caee/Low-Cost-Bioprinter/Figures/Printer_side.png

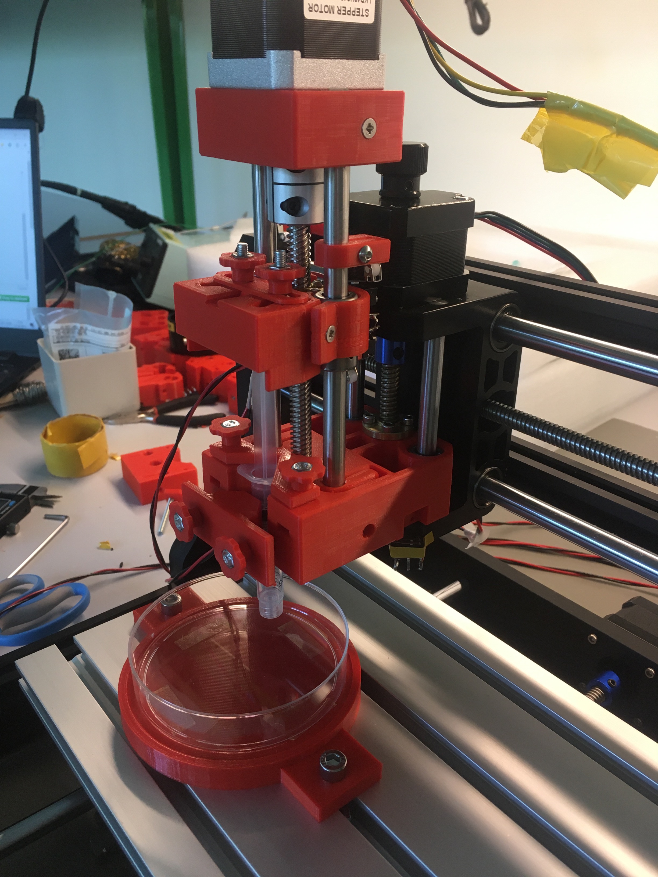
Figures/Printer_side.png
