caee/Low-Cost-Bioprinter/Design/Syringe/Open-Source_Syringe_Pump_4194094/images/featured_preview_glass_100ul.jpg

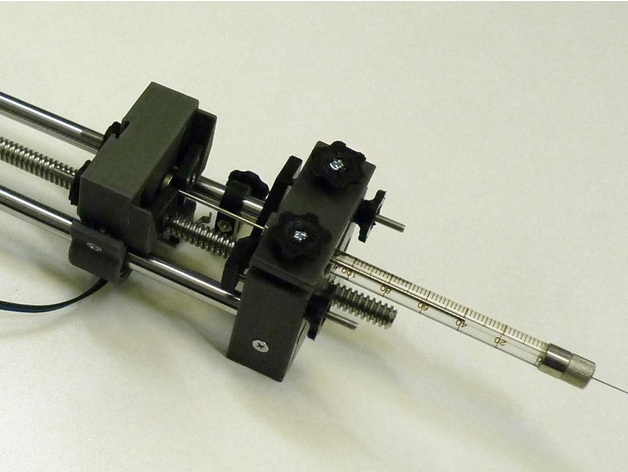
Design/Syringe/Open-Source_Syringe_Pump_4194094/images/featured_preview_glass_100ul.jpg
