caee/Low-Cost-Bioprinter/Design/Syringe/Ender3-syringe-pumps-main/README.md

# Ender 3 syringe pumps: 
open-source set of syringe pumps from an Ender 3 kit

**If you use the pump in your research, please cite:**

**Sander Baas, Vittorio Saggiomo,
Ender3 3D printer kit transformed into open, programmable syringe pump set,
HardwareX, Volume 10, 2021,
e00219, https://doi.org/10.1016/j.ohx.2021.e00219.**



Visit [**ChemRxiv**][2] for the preprint, and [**HardwareX**][3] for the published paper. 

A video of the project is here: https://www.youtube.com/watch?v=etUp4s1Bq-I

Ender 3 syringe pumps is an open source and open hardware device for converting an Ender 3 kit to a set of 3 syringe pumps. Almost everything needed for the build is the Ender 3 kit, even all the screws and the tools needed for the assembly. 
The only parts which needed to be bought are three 5x5 shaft couplers and M5 lead screw. 
All the 3D designs are in the /hardware folder. 

## Structure 
+ /hardware is a folder with the 3D printable files and a guide for the assembly 
+ /software is a folder with the instruction on how to use the pumps via gcode 
+ /videos are few video of the pumps in action

[1]: https://github.com/Vsaggiomo/Ender3-syringe-pumps/blob/main/Figures/fig1.jpg
[2]: https://chemrxiv.org/articles/preprint/Ender3_3D_Printer_Kit_Transformed_into_Open_Programmable_Syringe_Pump_Set/14718183 
[3]: https://doi.org/10.1016/j.ohx.2021.e00219
