caee/Low-Cost-Bioprinter/Design/Syringe/Open-Source_Syringe_Pump_4194094/README.txt

Open-Source Syringe Pump by AndreySamokhin on Thingiverse: https://www.thingiverse.com/thing:4194094
