caee/Low-Cost-Bioprinter/Design/Syringe/Open-Source_Syringe_Pump_4194094/images/featured_preview_generalView_800x600.JPG

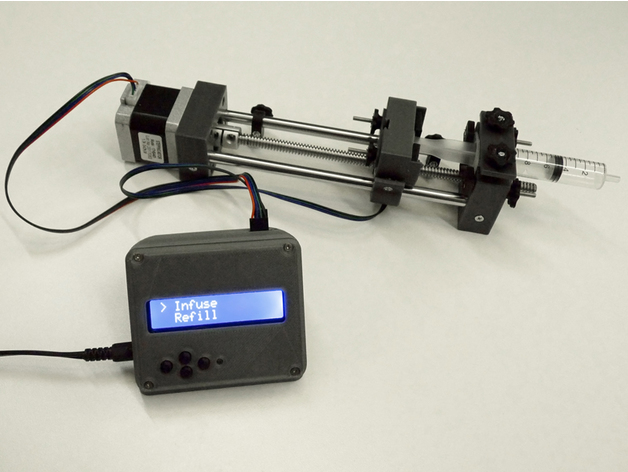
Design/Syringe/Open-Source_Syringe_Pump_4194094/images/featured_preview_generalView_800x600.JPG
