caee/Low-Cost-Bioprinter/Design/Syringe/Open-Source_Syringe_Pump_4194094/images/featured_preview_plastic_20mL.jpg

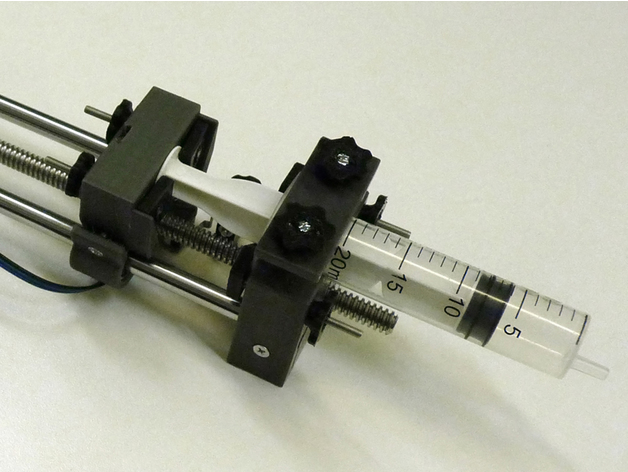
Design/Syringe/Open-Source_Syringe_Pump_4194094/images/featured_preview_plastic_20mL.jpg
