caee/Low-Cost-Bioprinter/Figures/backsupport.JPG

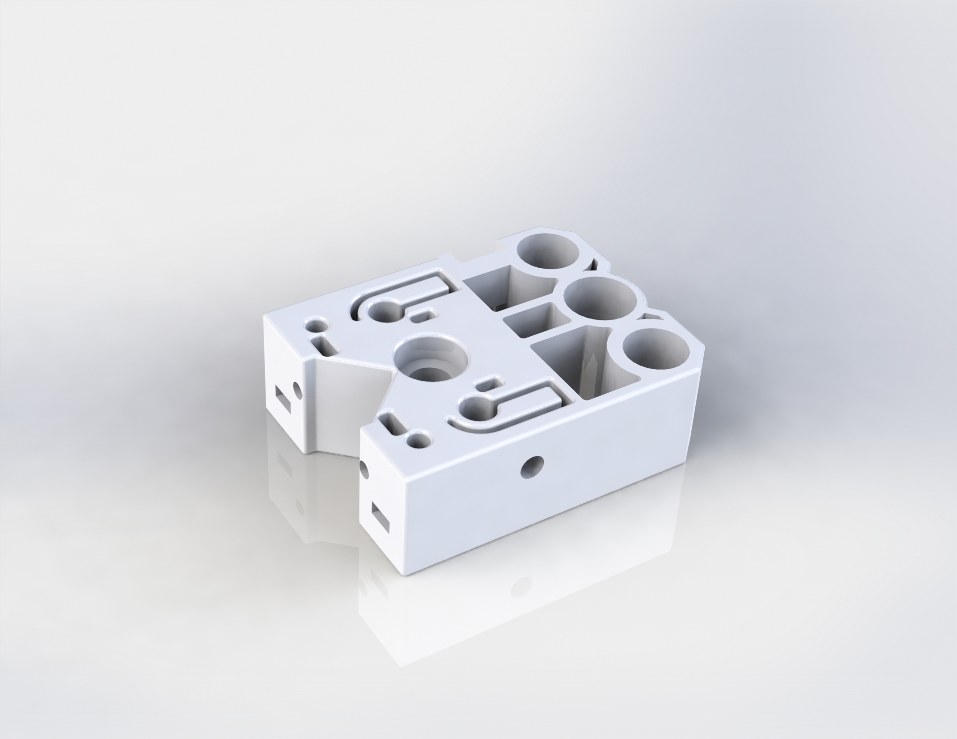
Figures/backsupport.JPG
