caee/Low-Cost-Bioprinter/Figures/backsupport_annotated.png

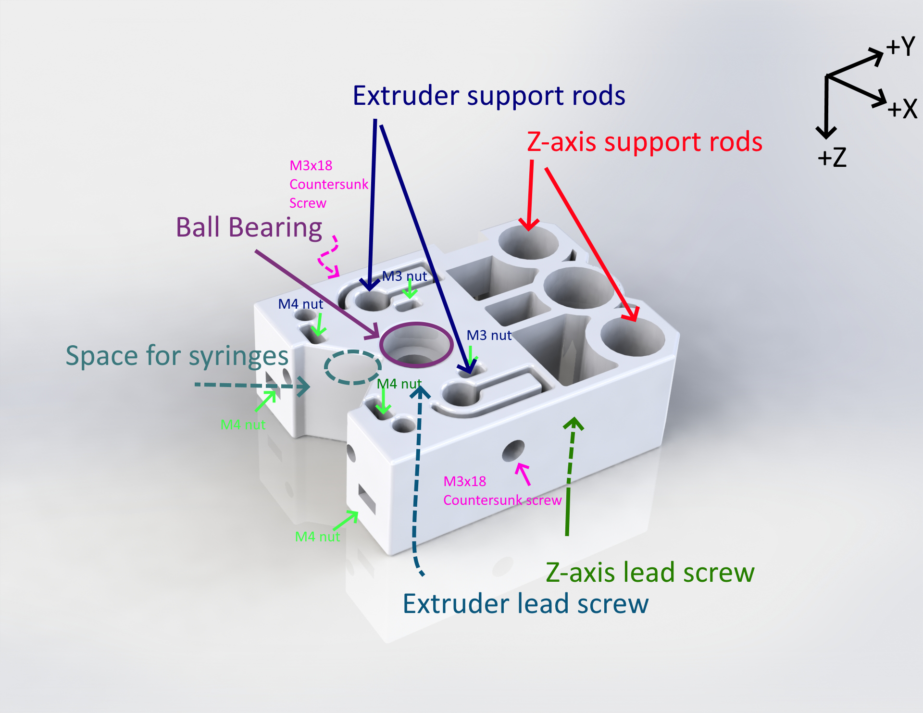
Figures/backsupport_annotated.png
