caee/Low-Cost-Bioprinter/Figures/SKR3 EZ.png

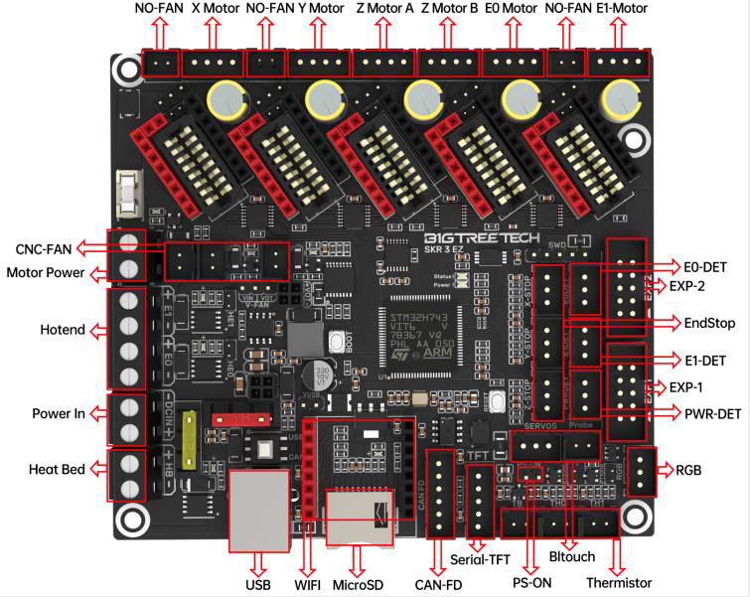
Figures/SKR3 EZ.png
