caee/Low-Cost-Bioprinter/Figures/SKR3EZ_Pin.png

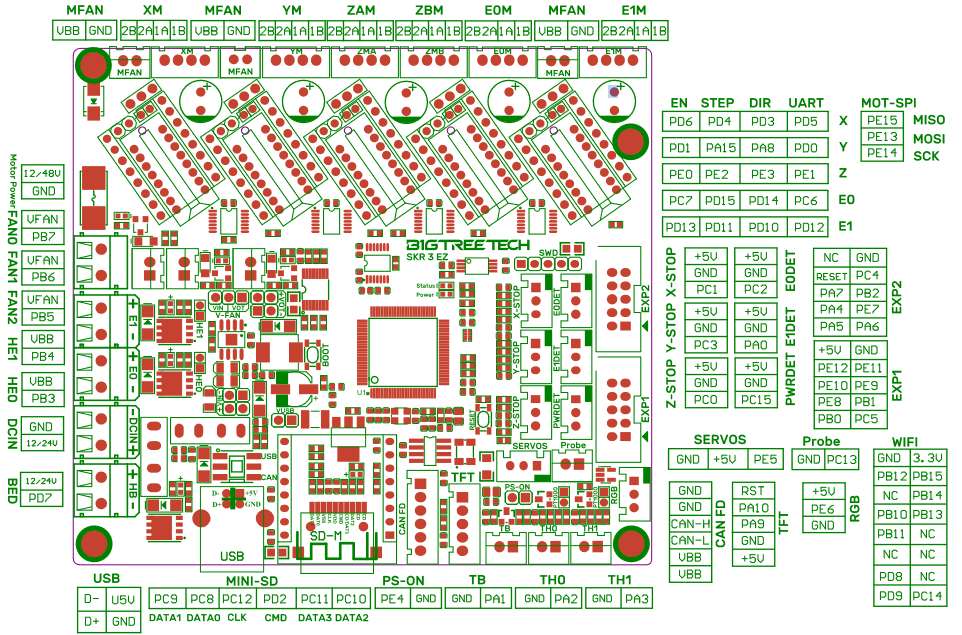
Figures/SKR3EZ_Pin.png
