caee/Low-Cost-Bioprinter/Figures/Syringe_closeup.png

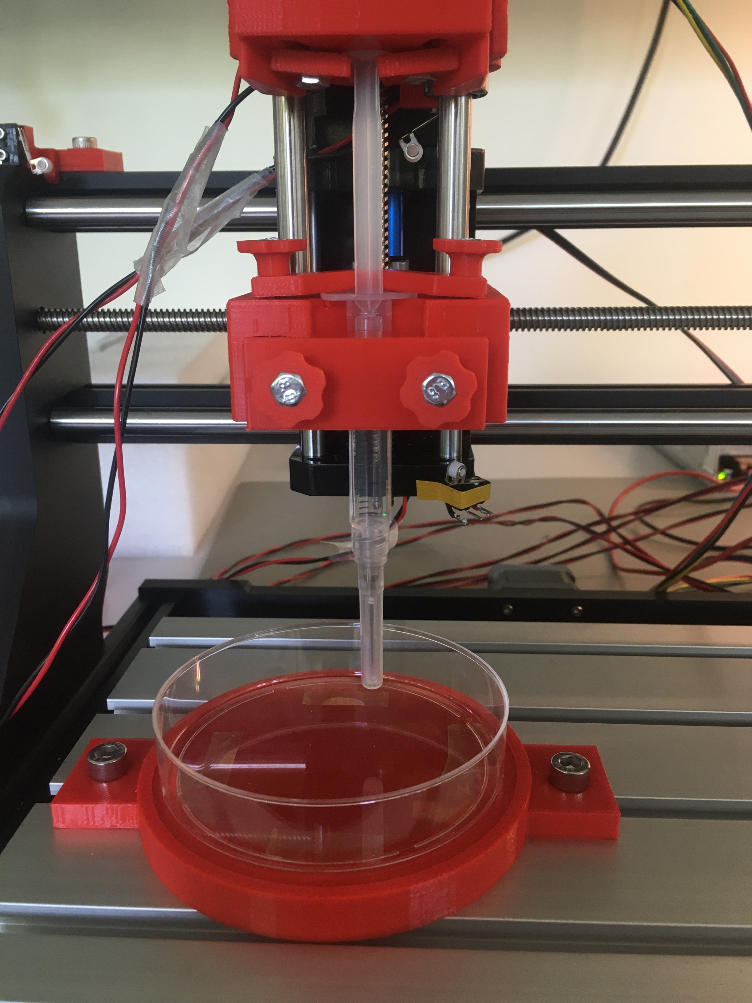
Figures/Syringe_closeup.png
