caee/Low-Cost-Bioprinter/Figures/syringe_render.JPG

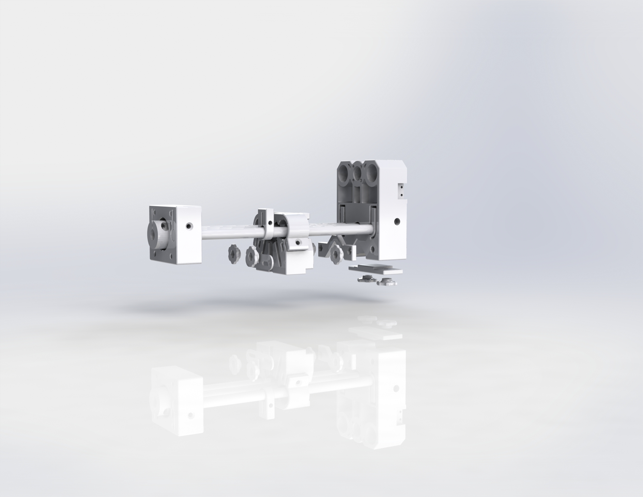
Figures/syringe_render.JPG
