caee/Low-Cost-Bioprinter/Figures/syringe_render.png

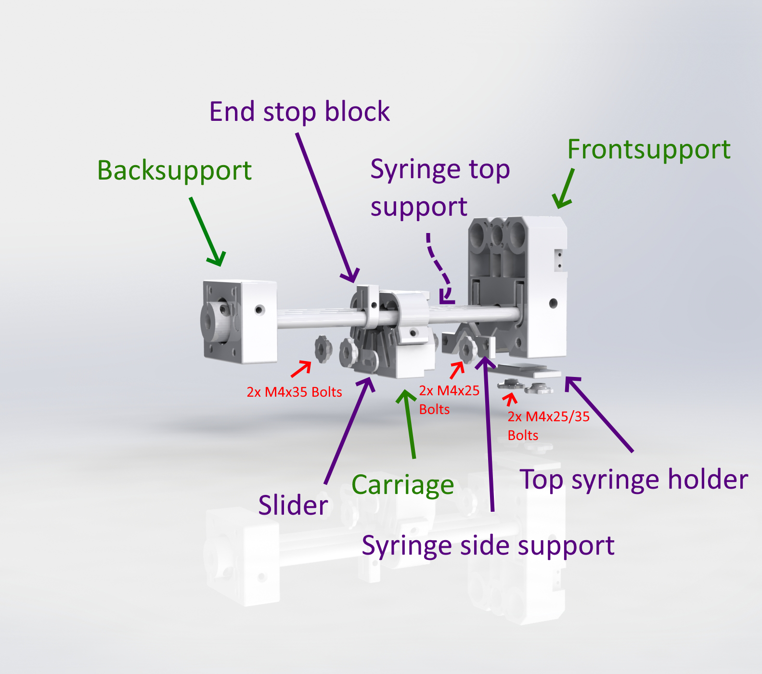
Figures/syringe_render.png
