caee/Low-Cost-Bioprinter/Design/BIGTREETECH SKR 3 board only.SLDASM

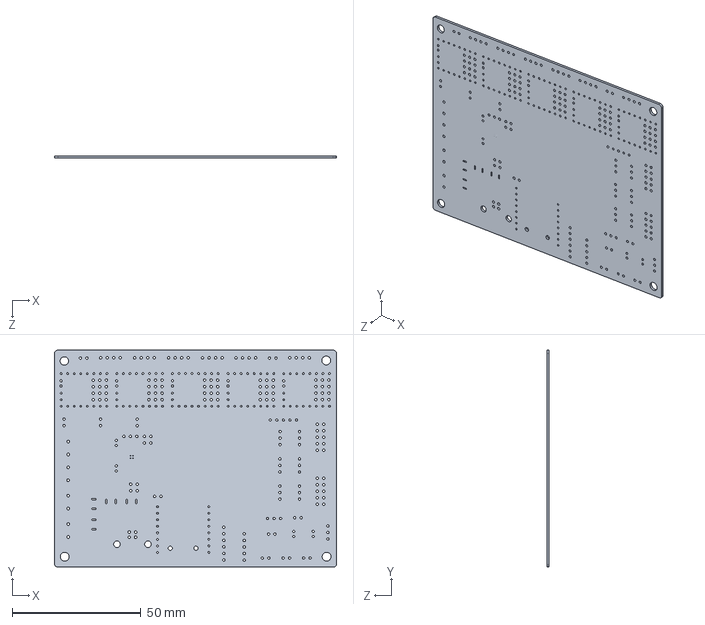
[picture p14: CAD file, 2023-06-23]
Design/BIGTREETECH SKR 3 board only.SLDASM
109.7 x 84.3 x 0.945 mm
