caee/Low-Cost-Bioprinter/Design/Syringe/PumpAssemv0_1.SLDASM

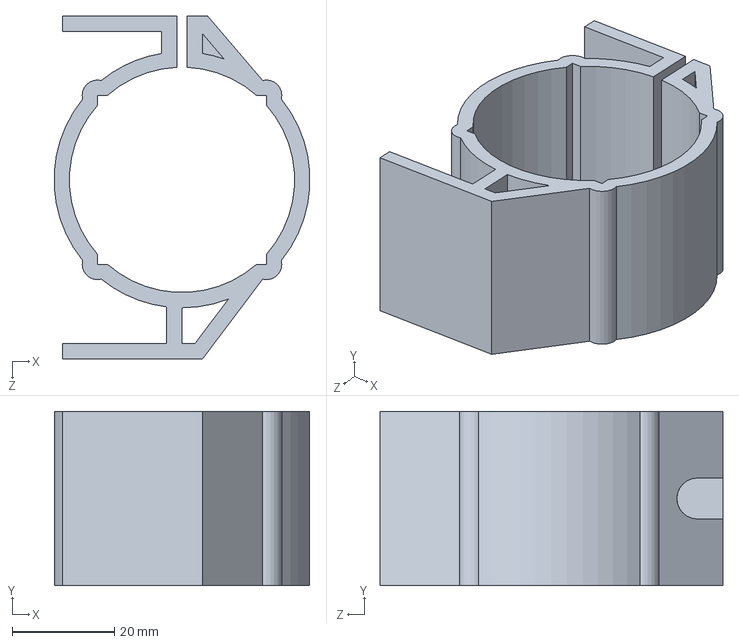
[picture p15: CAD file, 2023-06-23]
Design/Syringe/PumpAssemv0_1.SLDASM
49.9 x 34.0 x 67.0 mm
