caee/Low-Cost-Bioprinter/Design/Syringe/Ender3-syringe-pumps-main/Hardware/sldprt/Assembly.SLDASM

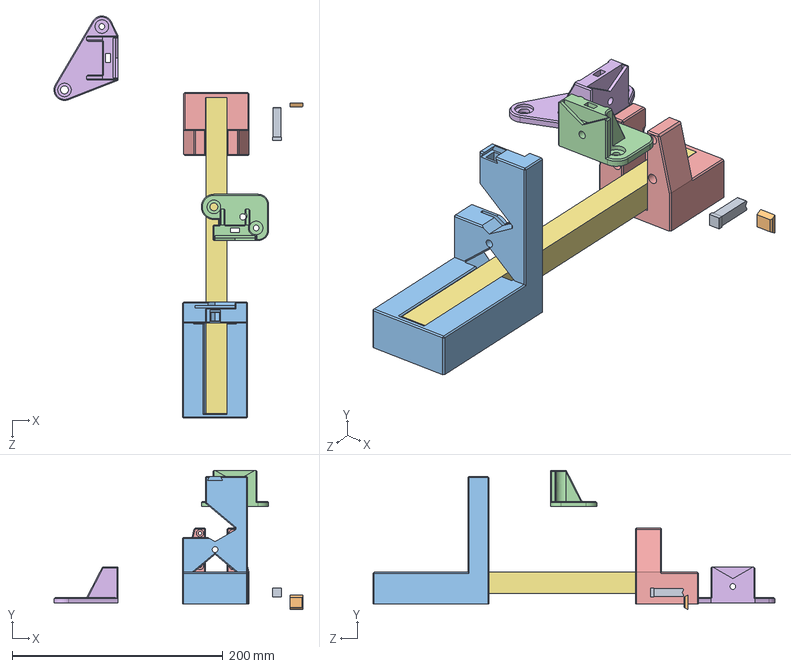
[picture p16: CAD file, 2023-06-23]
Design/Syringe/Ender3-syringe-pumps-main/Hardware/sldprt/Assembly.SLDASM
236.4 x 132.3 x 381.6 mm
Clamp Bar long v1
Dovetail Cap
E End Mount
E Slide Mount
E Stepper Mount
X Motor Slide Mount
Part5^Assembly
