caee/Low-Cost-Bioprinter/Design/Physical printer design/Printer_Assem_v01.SLDASM

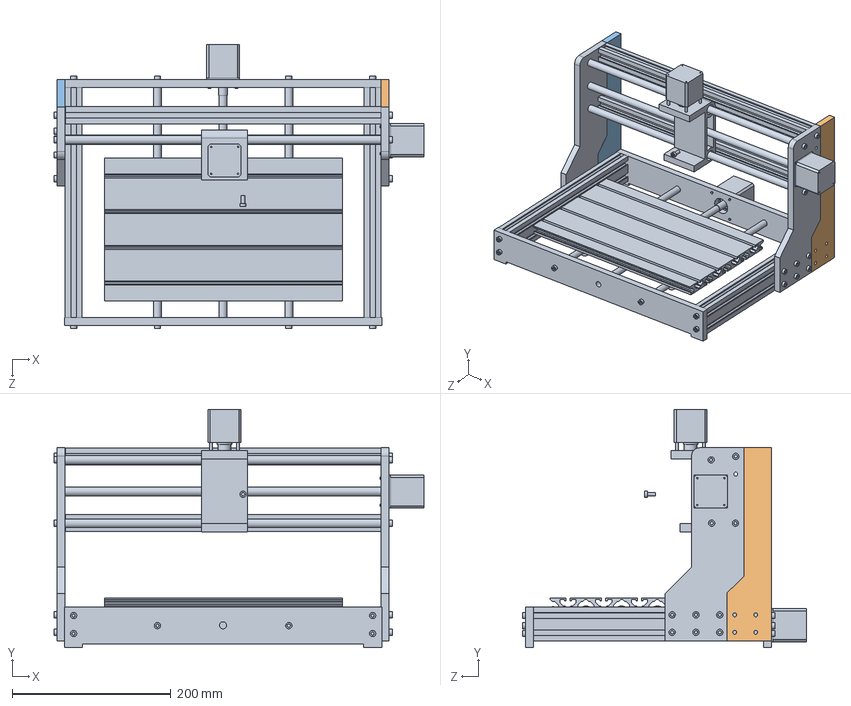
[picture p17: CAD file, 2023-06-23]
Design/Physical printer design/Printer_Assem_v01.SLDASM
466.4 x 300.3 x 358.0 mm
Closed_case_design
Part2^Printer_Assem_v01
MirrorPart2^Printer_Assem_v01
