caee/Low-Cost-Bioprinter/Design/Syringe/Ender3-syringe-pumps-main/Hardware/Ender 3 V2/psu_mount_Ender3v2.stl

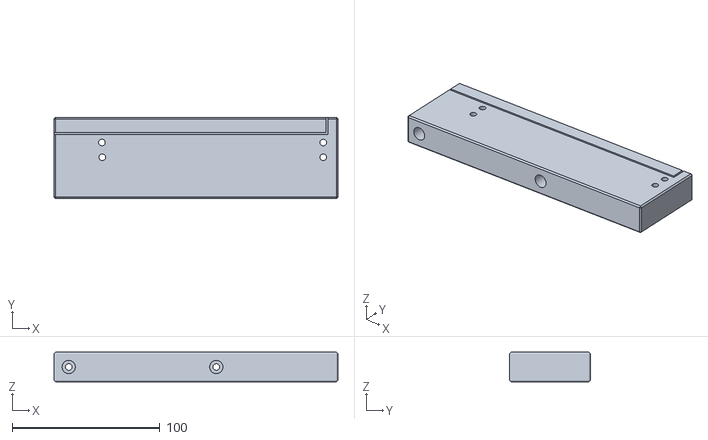
[picture p18: CAD file, 2023-06-23]
Design/Syringe/Ender3-syringe-pumps-main/Hardware/Ender 3 V2/psu_mount_Ender3v2.stl
192.5 x 55.0 x 20.0
