caee/Low-Cost-Bioprinter/Design/Syringe/Ender3-syringe-pumps-main/Hardware/sldprt/Clamp Bar Short.SLDPRT

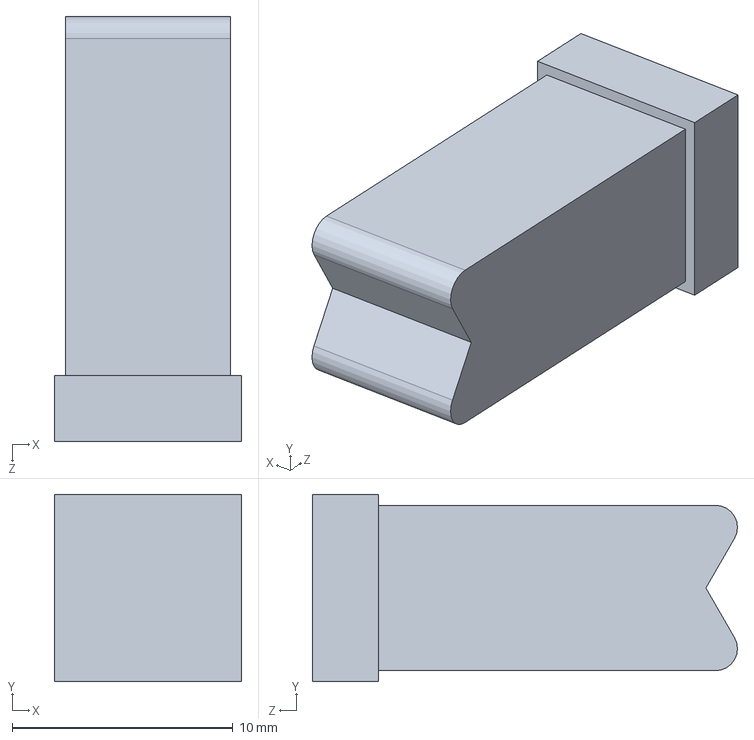
[picture p19: CAD file, 2023-06-23]
Design/Syringe/Ender3-syringe-pumps-main/Hardware/sldprt/Clamp Bar Short.SLDPRT
8.50 x 8.50 x 19.3 mm
