caee/Low-Cost-Bioprinter/Design/Syringe/Ender3-syringe-pumps-main/Hardware/STEP/X X Motor Stepper Mount v1.step

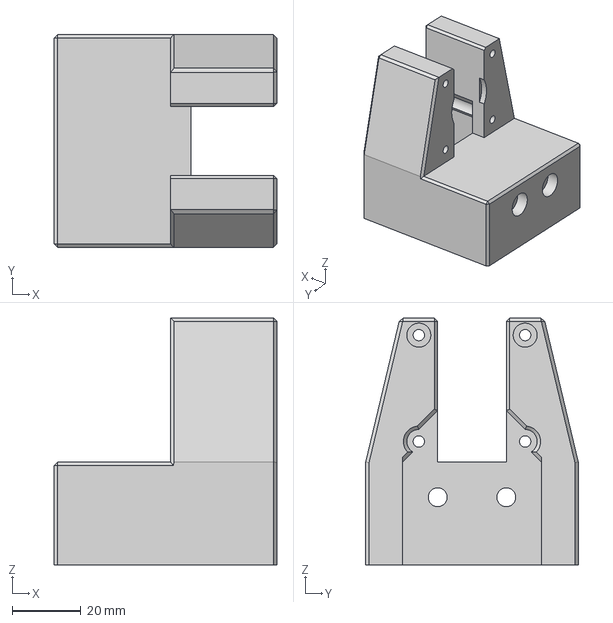
[picture p20: CAD file, 2023-06-23]
Design/Syringe/Ender3-syringe-pumps-main/Hardware/STEP/X X Motor Stepper Mount v1.step
65.0 x 62.0 x 72.0 mm
