caee/Low-Cost-Bioprinter/Design/Syringe/Ender3-syringe-pumps-main/Hardware/STL/50 mL adaptors/X X Motor End Mount 50 mL.stl

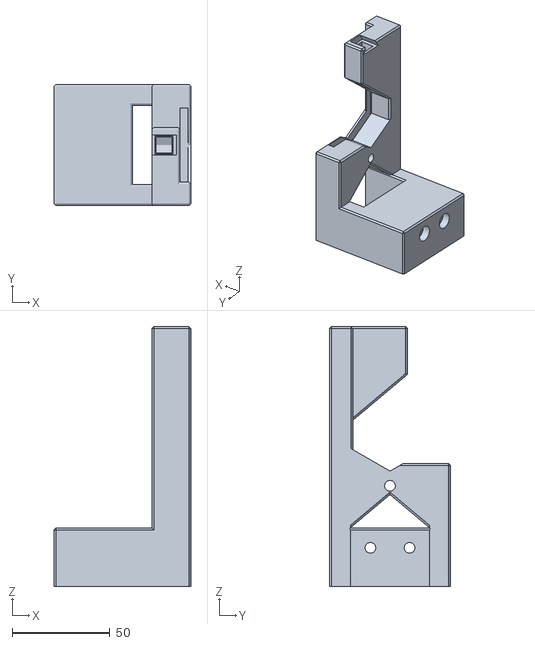
[picture p21: CAD file, 2023-06-23]
Design/Syringe/Ender3-syringe-pumps-main/Hardware/STL/50 mL adaptors/X X Motor End Mount 50 mL.stl
70.0 x 62.0 x 133.0
