caee/Low-Cost-Bioprinter/Design/Syringe/Ender3-syringe-pumps-main/Hardware/STL/Double Syringe/X Motor Slide Mount Dual.stl

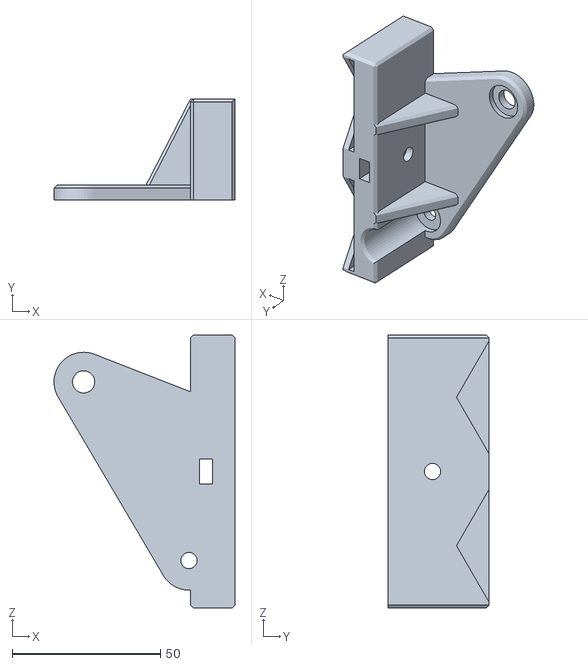
[picture p22: CAD file, 2023-06-23]
Design/Syringe/Ender3-syringe-pumps-main/Hardware/STL/Double Syringe/X Motor Slide Mount Dual.stl
61.0 x 34.0 x 92.0
