caee/Low-Cost-Bioprinter/Design/Syringe/Ender3-syringe-pumps-main/Hardware/STL/Large shaft coupler/E Stepper Mount Large Shaft Coupler v1.stl.stl

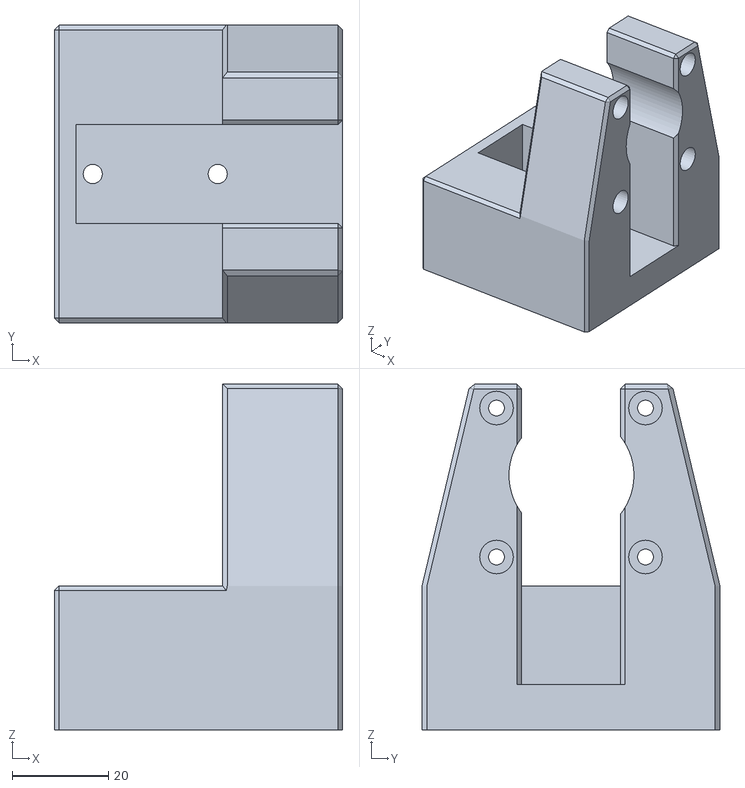
[picture p23: CAD file, 2023-06-23]
Design/Syringe/Ender3-syringe-pumps-main/Hardware/STL/Large shaft coupler/E Stepper Mount Large Shaft Coupler v1.stl.stl
60.0 x 62.0 x 72.0
