caee/Low-Cost-Bioprinter/Design/Syringe/Ender3-syringe-pumps-main/Hardware/STL/PressFitPulleyExtractor.stl

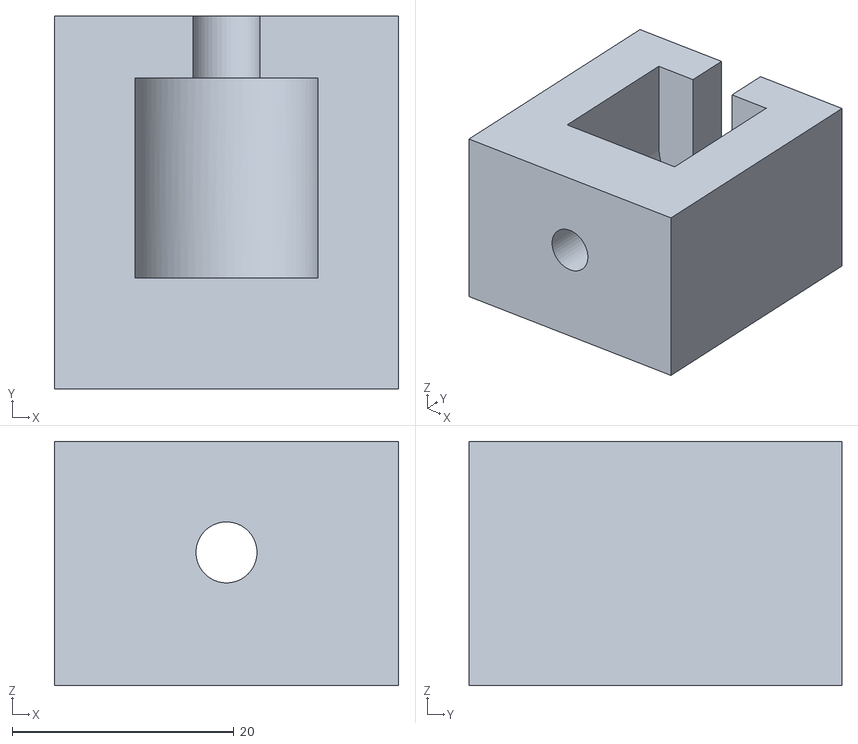
[picture p24: CAD file, 2023-06-23]
Design/Syringe/Ender3-syringe-pumps-main/Hardware/STL/PressFitPulleyExtractor.stl
31.0 x 33.6 x 22.0
