caee/Low-Cost-Bioprinter/Design/petri_holder_10mm.SLDPRT

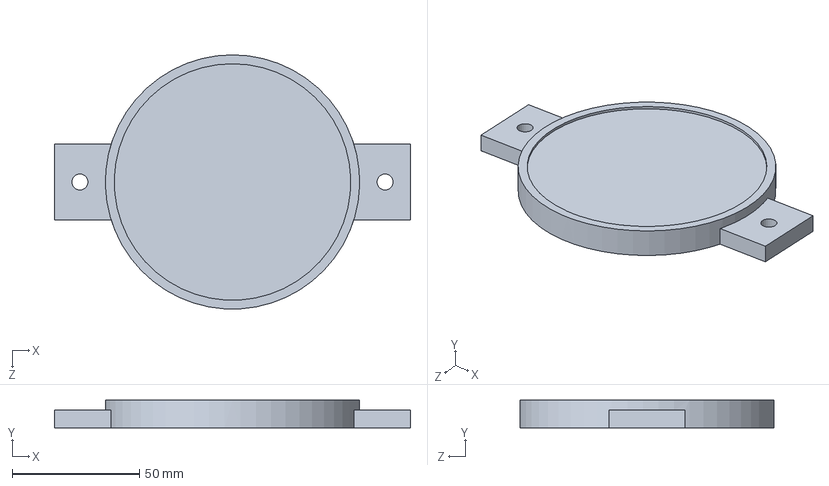
[picture p26: CAD file, 2023-06-23]
Design/petri_holder_10mm.SLDPRT
140.0 x 11.0 x 100.0 mm
