caee/Low-Cost-Bioprinter/Design/Syringe/Ender3-syringe-pumps-main/Hardware/sldprt/Dovetail Cap.SLDPRT

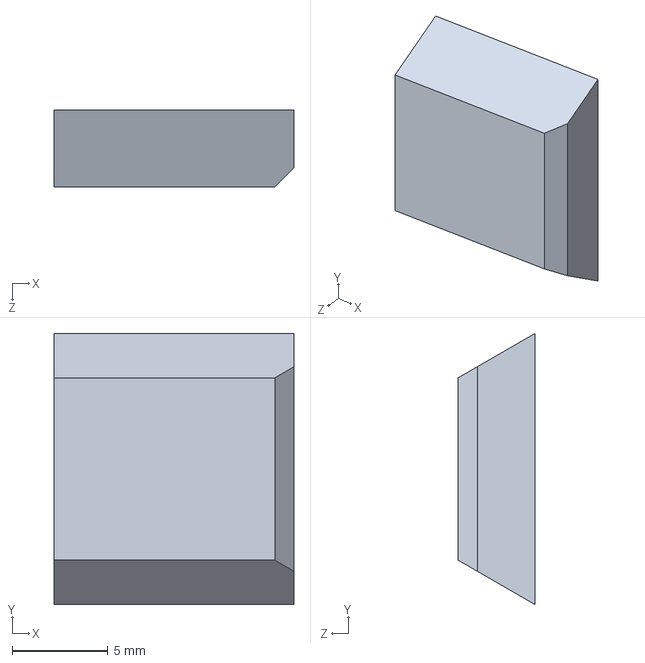
[picture p27: CAD file, 2023-06-23]
Design/Syringe/Ender3-syringe-pumps-main/Hardware/sldprt/Dovetail Cap.SLDPRT
12.5 x 14.1 x 4.00 mm
