caee/Low-Cost-Bioprinter/Design/Syringe/Ender3-syringe-pumps-main/Hardware/STL/50 mL adaptors/E End Mount 50 mL v2.stl

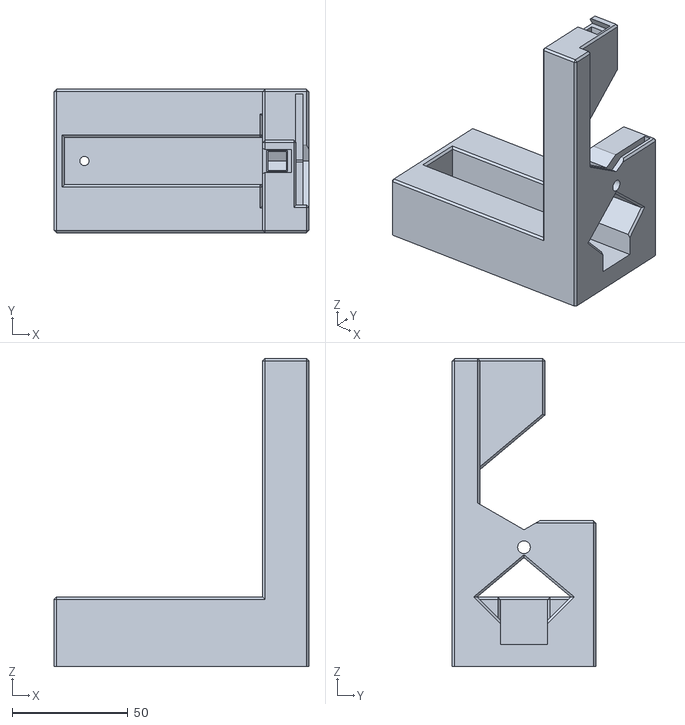
[picture p28: CAD file, 2023-06-23]
Design/Syringe/Ender3-syringe-pumps-main/Hardware/STL/50 mL adaptors/E End Mount 50 mL v2.stl
110.0 x 62.0 x 133.0
