caee/Low-Cost-Bioprinter/Design/Syringe/Ender3-syringe-pumps-main/Hardware/STL/Double Syringe/E Slide Mount Dual.stl

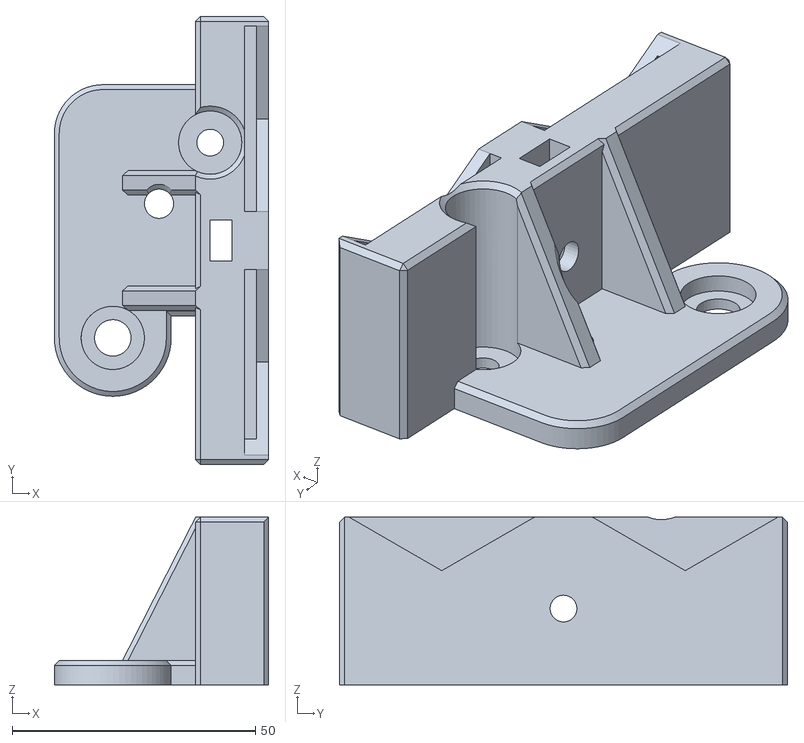
[picture p29: CAD file, 2023-06-23]
Design/Syringe/Ender3-syringe-pumps-main/Hardware/STL/Double Syringe/E Slide Mount Dual.stl
44.0 x 92.0 x 34.4
