caee/Low-Cost-Bioprinter/Design/Syringe/Open-Source_Syringe_Pump_4194094/files/wireHolder.SLDPRT

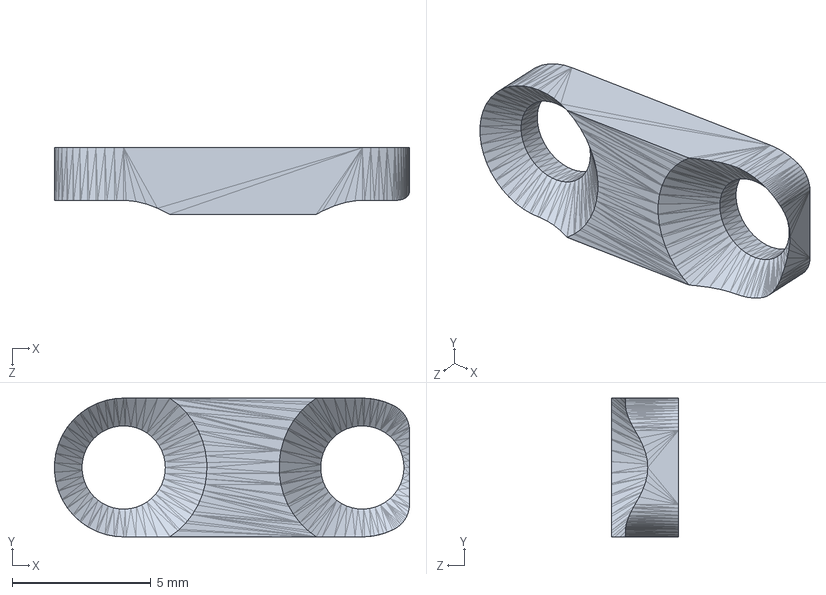
[picture p30: CAD file, 2023-06-23]
Design/Syringe/Open-Source_Syringe_Pump_4194094/files/wireHolder.SLDPRT
12.8 x 5.00 x 2.40 mm
