caee/Low-Cost-Bioprinter/Design/petri_holder.SLDPRT

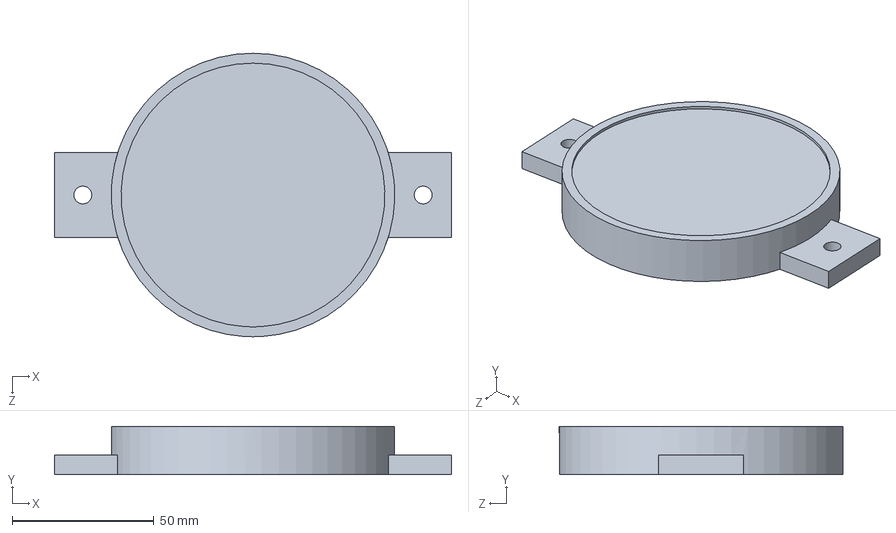
[picture p31: CAD file, 2023-06-23]
Design/petri_holder.SLDPRT
140.0 x 17.0 x 100.0 mm
