caee/Low-Cost-Bioprinter/Design/Syringe/Ender3-syringe-pumps-main/Hardware/STL/50 mL adaptors/X X Motor End Mount Dual 50 mL.stl

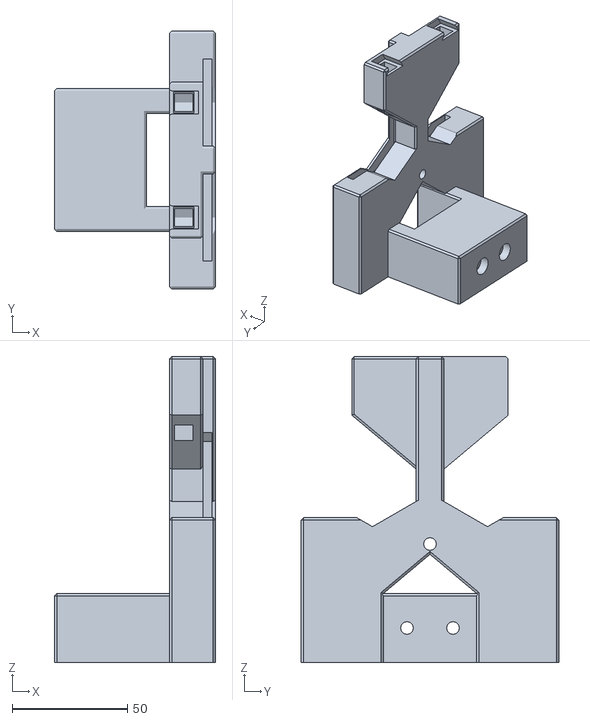
[picture p32: CAD file, 2023-06-23]
Design/Syringe/Ender3-syringe-pumps-main/Hardware/STL/50 mL adaptors/X X Motor End Mount Dual 50 mL.stl
70.0 x 112.0 x 133.0
