caee/Low-Cost-Bioprinter/Design/Syringe/Ender3-syringe-pumps-main/Hardware/STL/Double Syringe/E End Mount Dual.stl

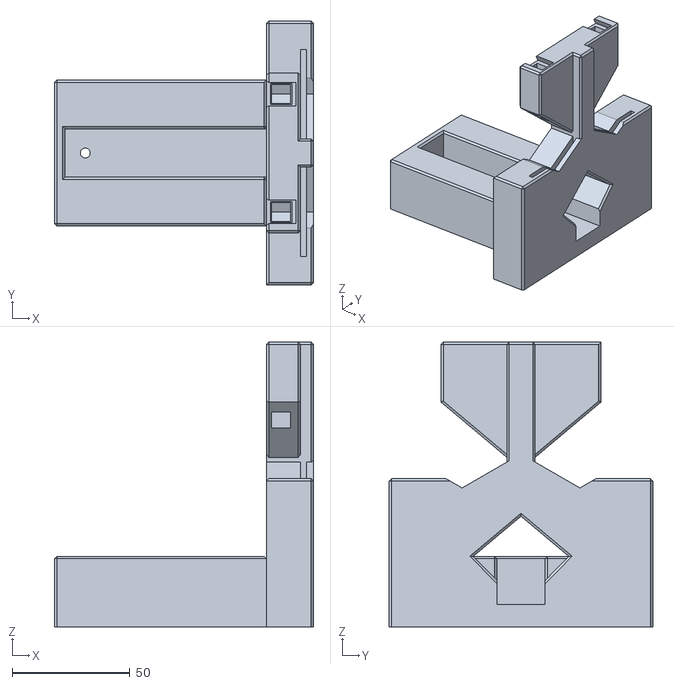
[picture p33: CAD file, 2023-06-23]
Design/Syringe/Ender3-syringe-pumps-main/Hardware/STL/Double Syringe/E End Mount Dual.stl
110.0 x 112.0 x 121.0
