caee/Low-Cost-Bioprinter/Design/Syringe/Ender3-syringe-pumps-main/Hardware/sldprt/Electronics Base.SLDPRT

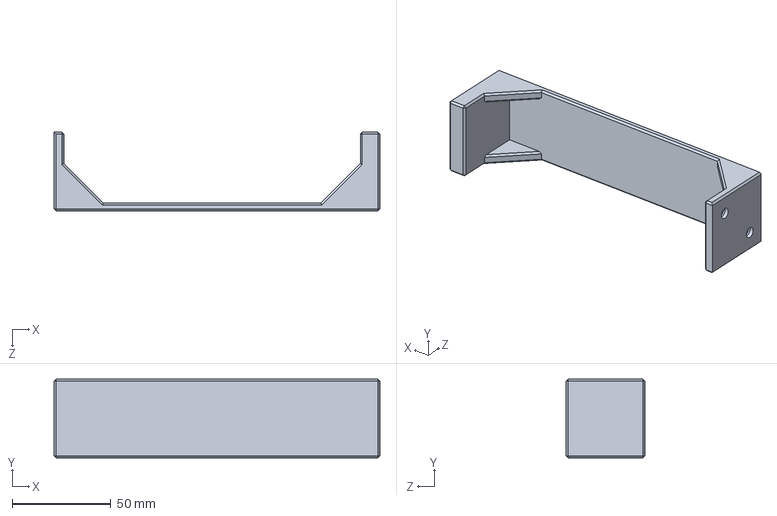
[picture p35: CAD file, 2023-06-23]
Design/Syringe/Ender3-syringe-pumps-main/Hardware/sldprt/Electronics Base.SLDPRT
165.2 x 40.0 x 40.0 mm
