caee/Low-Cost-Bioprinter/Design/Syringe/Ender3-syringe-pumps-main/Hardware/STL/Double Syringe/X X Motor End Mount Dual.stl

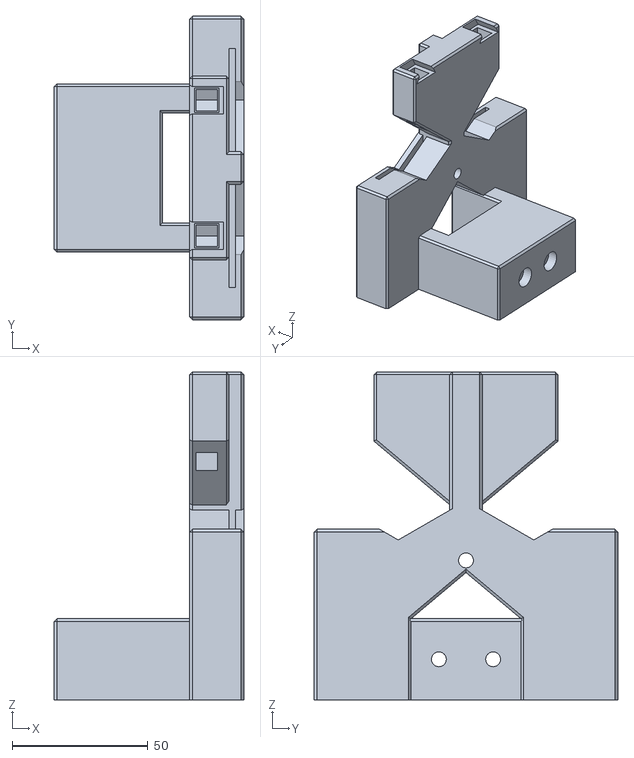
[picture p36: CAD file, 2023-06-23]
Design/Syringe/Ender3-syringe-pumps-main/Hardware/STL/Double Syringe/X X Motor End Mount Dual.stl
70.0 x 112.0 x 121.0
