caee/Low-Cost-Bioprinter/Design/y_endstop.SLDPRT

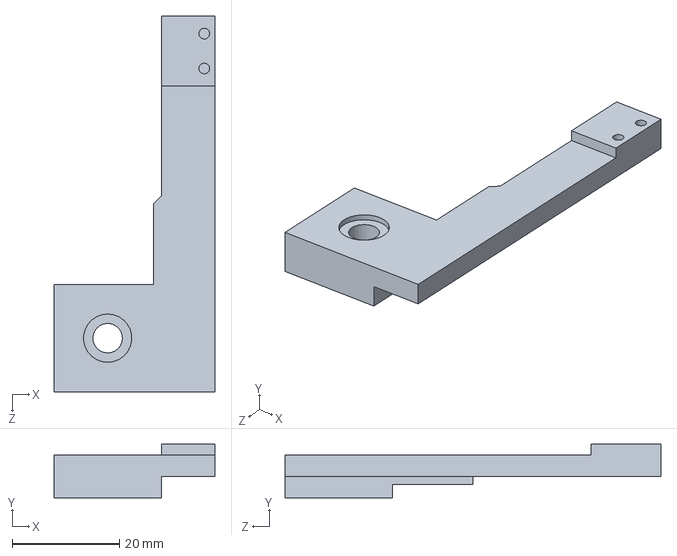
[picture p37: CAD file, 2023-06-23]
Design/y_endstop.SLDPRT
30.0 x 10.0 x 70.0 mm
