caee/Low-Cost-Bioprinter/Design/Syringe/Ender3-syringe-pumps-main/Hardware/sldprt/E End Mount.SLDPRT

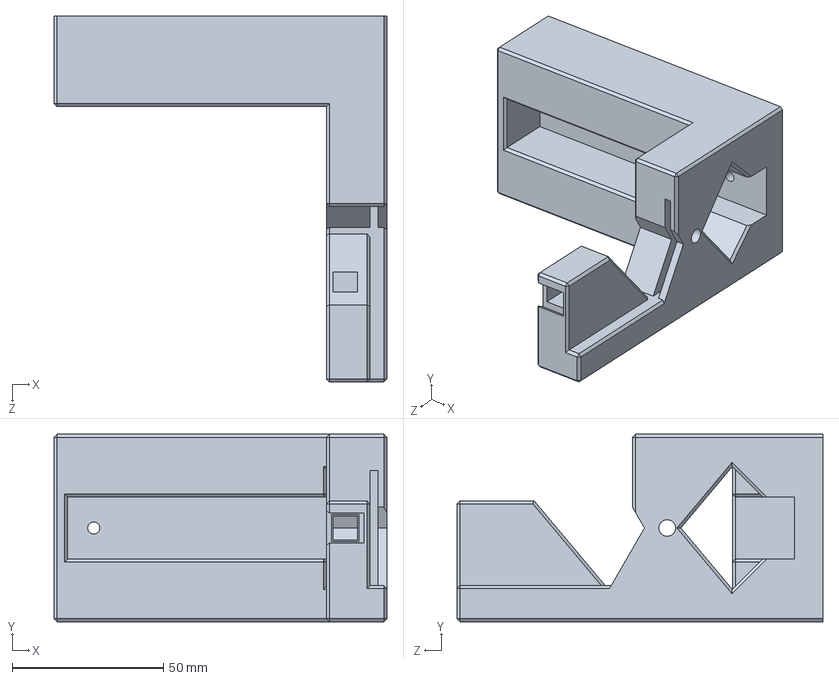
[picture p38: CAD file, 2023-06-23]
Design/Syringe/Ender3-syringe-pumps-main/Hardware/sldprt/E End Mount.SLDPRT
110.0 x 62.0 x 121.0 mm
