caee/Low-Cost-Bioprinter/Design/Syringe/Ender3-syringe-pumps-main/Hardware/STEP/E Slide Mount v1.step

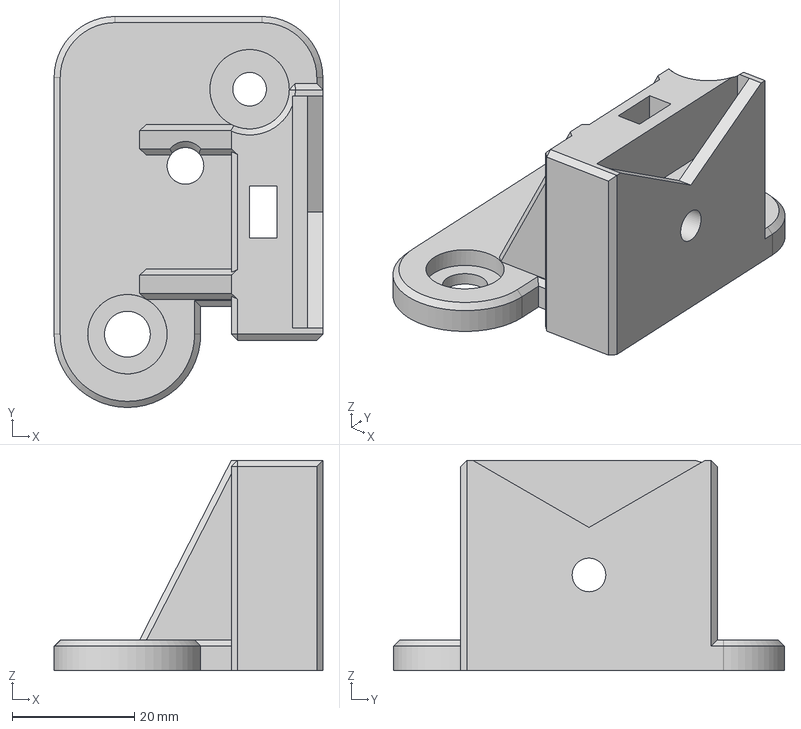
[picture p39: CAD file, 2023-06-23]
Design/Syringe/Ender3-syringe-pumps-main/Hardware/STEP/E Slide Mount v1.step
44.0 x 64.0 x 34.4 mm
