caee/Low-Cost-Bioprinter/Design/Syringe/Ender3-syringe-pumps-main/Hardware/STL/Double Syringe/X Slide Mount Dual.stl

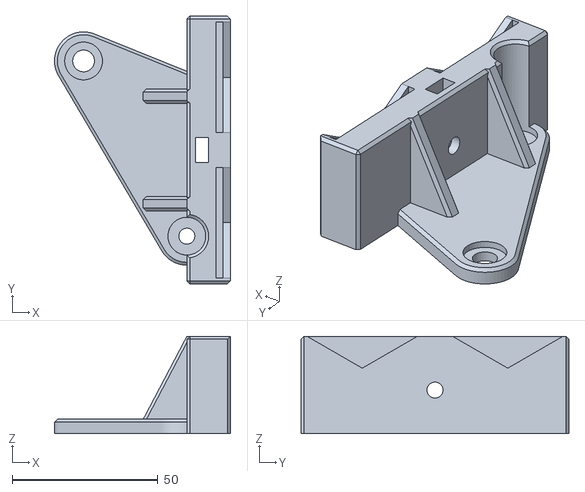
[picture p40: CAD file, 2023-06-23]
Design/Syringe/Ender3-syringe-pumps-main/Hardware/STL/Double Syringe/X Slide Mount Dual.stl
60.5 x 92.0 x 33.5
