caee/Low-Cost-Bioprinter/Design/x_endstop.SLDPRT

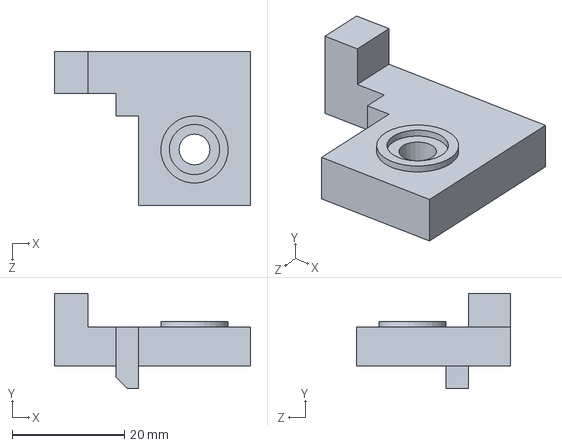
[picture p42: CAD file, 2023-06-23]
Design/x_endstop.SLDPRT
35.0 x 17.0 x 27.5 mm
