caee/Low-Cost-Bioprinter/Design/Syringe/Ender3-syringe-pumps-main/Hardware/STL/50 mL adaptors/E End Mount Dual 50 mL.stl

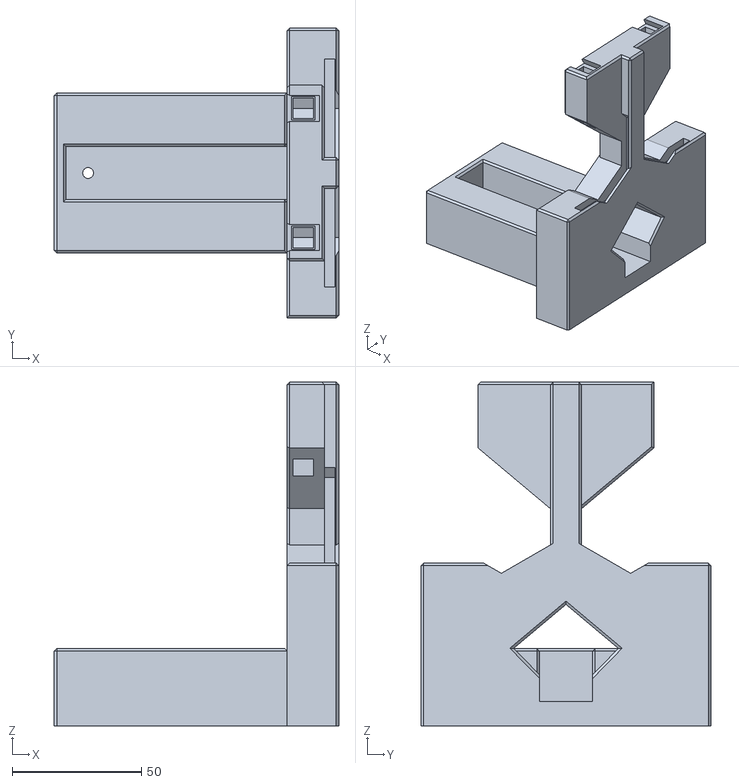
[picture p43: CAD file, 2023-06-23]
Design/Syringe/Ender3-syringe-pumps-main/Hardware/STL/50 mL adaptors/E End Mount Dual 50 mL.stl
110.0 x 112.0 x 133.0
