caee/Low-Cost-Bioprinter/Design/Syringe/Open-Source_Syringe_Pump_4194094/files/couplingM4.STL

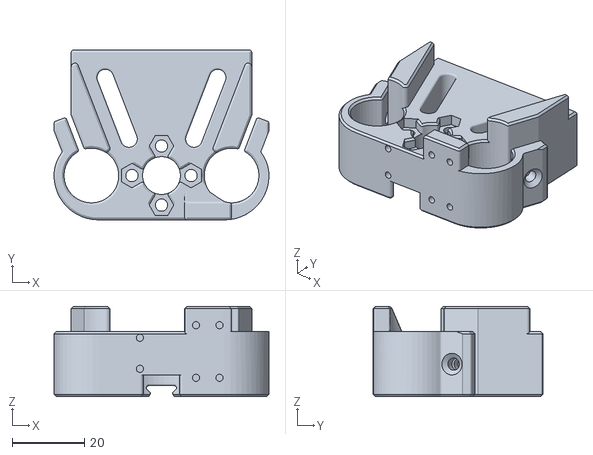
[picture p44: CAD file, 2023-06-23]
Design/Syringe/Open-Source_Syringe_Pump_4194094/files/couplingM4.STL
59.7 x 47.1 x 25.0
