caee/Low-Cost-Bioprinter/Design/Syringe/Ender3-syringe-pumps-main/Hardware/sldprt/X Motor Slide Mount.SLDPRT

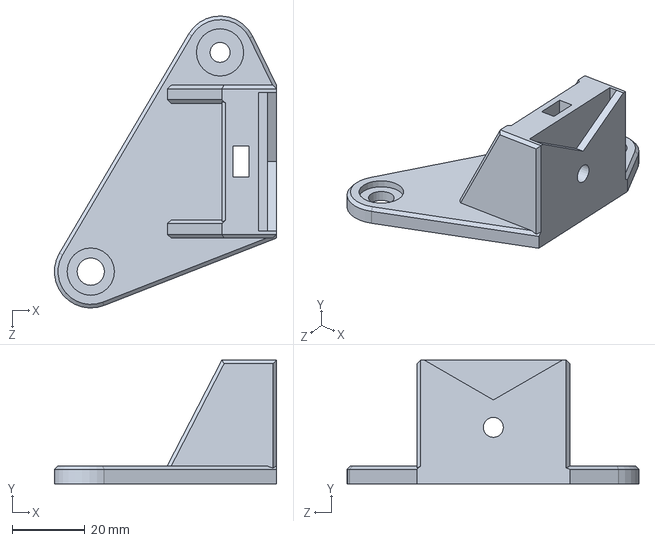
[picture p45: CAD file, 2023-06-23]
Design/Syringe/Ender3-syringe-pumps-main/Hardware/sldprt/X Motor Slide Mount.SLDPRT
61.0 x 34.0 x 80.2 mm
