caee/Low-Cost-Bioprinter/Design/Syringe/Open-Source_Syringe_Pump_4194094/files/slider.SLDPRT

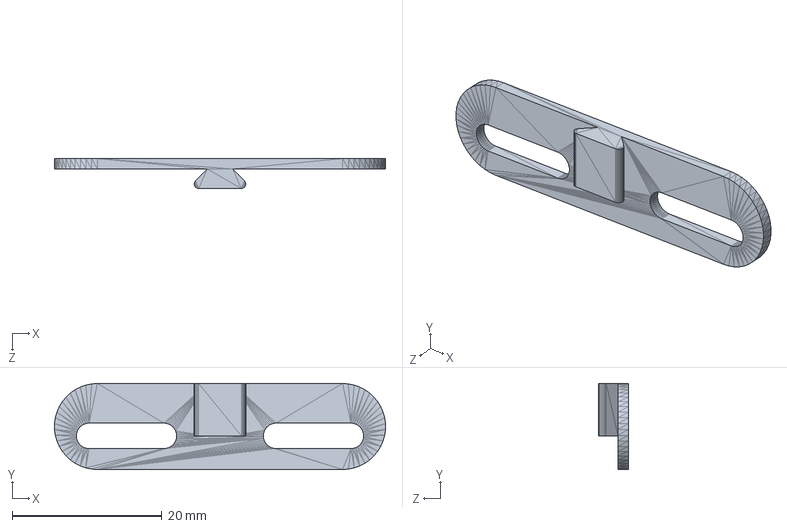
[picture p46: CAD file, 2023-06-23]
Design/Syringe/Open-Source_Syringe_Pump_4194094/files/slider.SLDPRT
44.2 x 11.5 x 4.00 mm
