caee/Low-Cost-Bioprinter/Design/Syringe/Ender3-syringe-pumps-main/Hardware/sldprt/Clamp Bar.SLDPRT

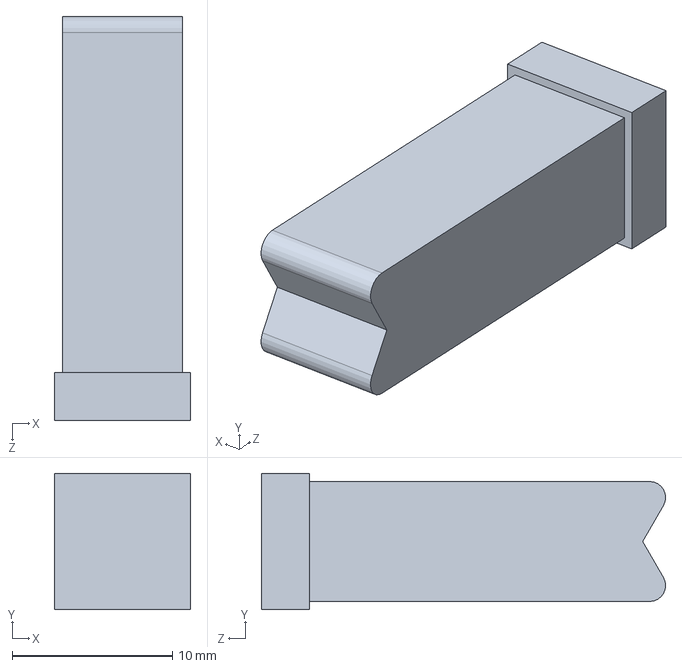
[picture p47: CAD file, 2023-06-23]
Design/Syringe/Ender3-syringe-pumps-main/Hardware/sldprt/Clamp Bar.SLDPRT
8.50 x 8.50 x 25.3 mm
