caee/Low-Cost-Bioprinter/Design/Syringe/Ender3-syringe-pumps-main/Hardware/STEP/X Slide Mount v1.step

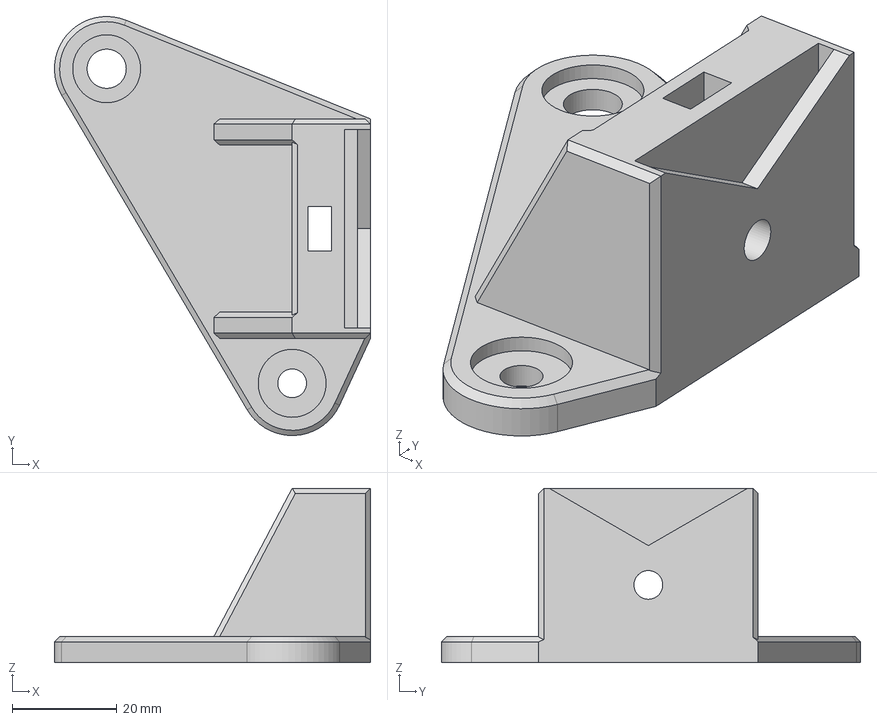
[picture p48: CAD file, 2023-06-23]
Design/Syringe/Ender3-syringe-pumps-main/Hardware/STEP/X Slide Mount v1.step
60.5 x 80.2 x 33.4 mm
