caee/Low-Cost-Bioprinter/Design/Syringe/Open-Source_Syringe_Pump_4194094/files/plungerHoldersM4.SLDPRT

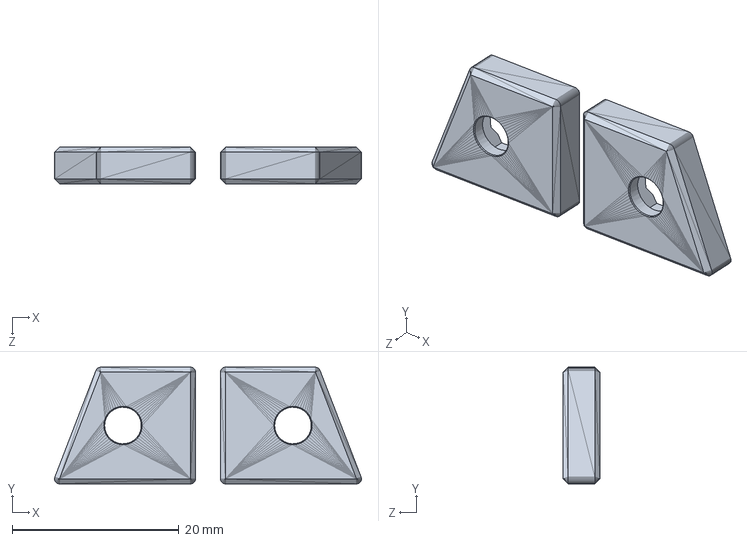
[picture p49: CAD file, 2023-06-23]
Design/Syringe/Open-Source_Syringe_Pump_4194094/files/plungerHoldersM4.SLDPRT
36.8 x 14.0 x 4.40 mm
