caee/Low-Cost-Bioprinter/Design/Syringe/Ender3-syringe-pumps-main/Hardware/STEP/PSU Mount v1.step

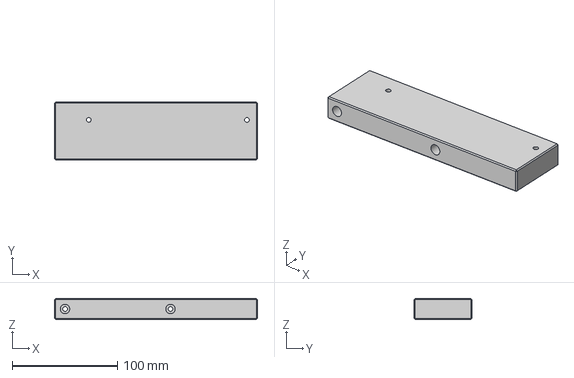
[picture p50: CAD file, 2023-06-23]
Design/Syringe/Ender3-syringe-pumps-main/Hardware/STEP/PSU Mount v1.step
192.5 x 55.0 x 20.0 mm
