caee/Low-Cost-Bioprinter/Design/Syringe/Open-Source_Syringe_Pump_4194094/files/handKnob9mm.stl

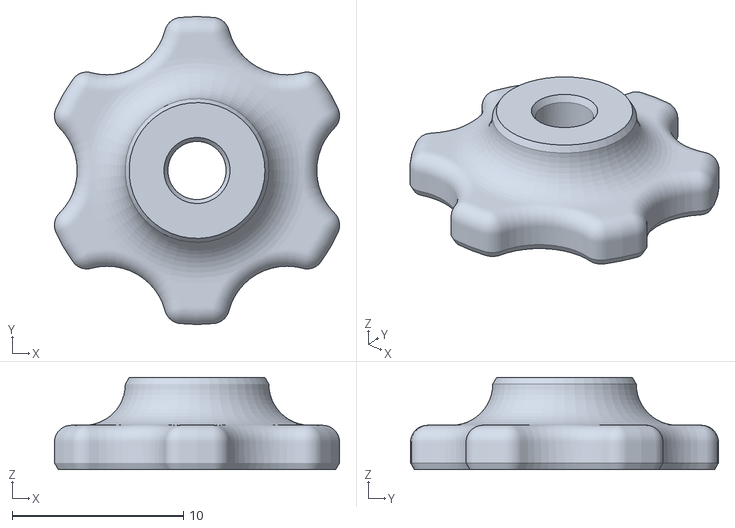
[picture p51: CAD file, 2023-06-23]
Design/Syringe/Open-Source_Syringe_Pump_4194094/files/handKnob9mm.stl
16.7 x 18.0 x 5.40
