caee/Low-Cost-Bioprinter/Design/Syringe/Ender3-syringe-pumps-main/Hardware/STEP/X X Motor End Mount v1.step

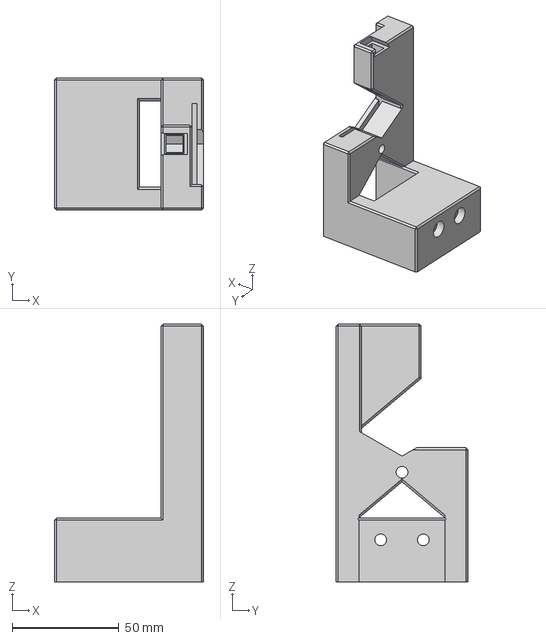
[picture p52: CAD file, 2023-06-23]
Design/Syringe/Ender3-syringe-pumps-main/Hardware/STEP/X X Motor End Mount v1.step
70.0 x 62.0 x 121.0 mm
