caee/Low-Cost-Bioprinter/Design/Syringe/Open-Source_Syringe_Pump_4194094/files/topSyringeHolder12mm.SLDPRT

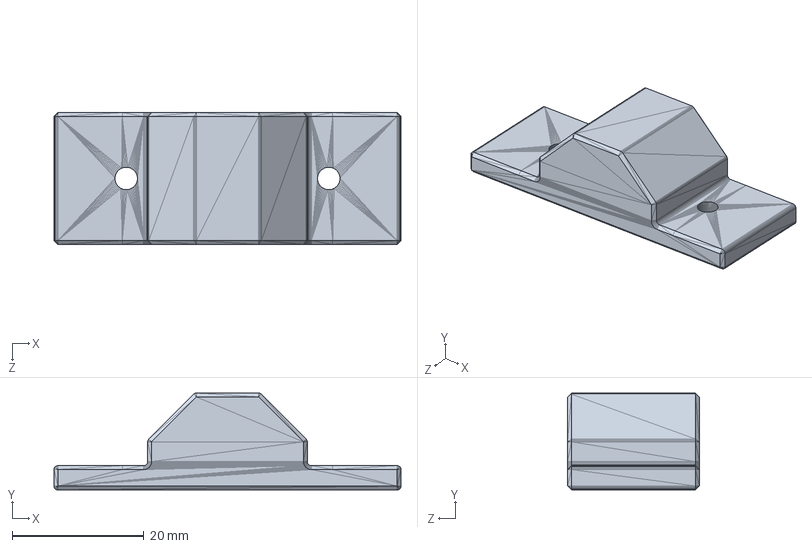
[picture p53: CAD file, 2023-06-23]
Design/Syringe/Open-Source_Syringe_Pump_4194094/files/topSyringeHolder12mm.SLDPRT
52.6 x 14.7 x 20.0 mm
