caee/Low-Cost-Bioprinter/Design/Syringe/Open-Source_Syringe_Pump_4194094/files/sideSyringeHolderM4FilledIn.SLDPRT

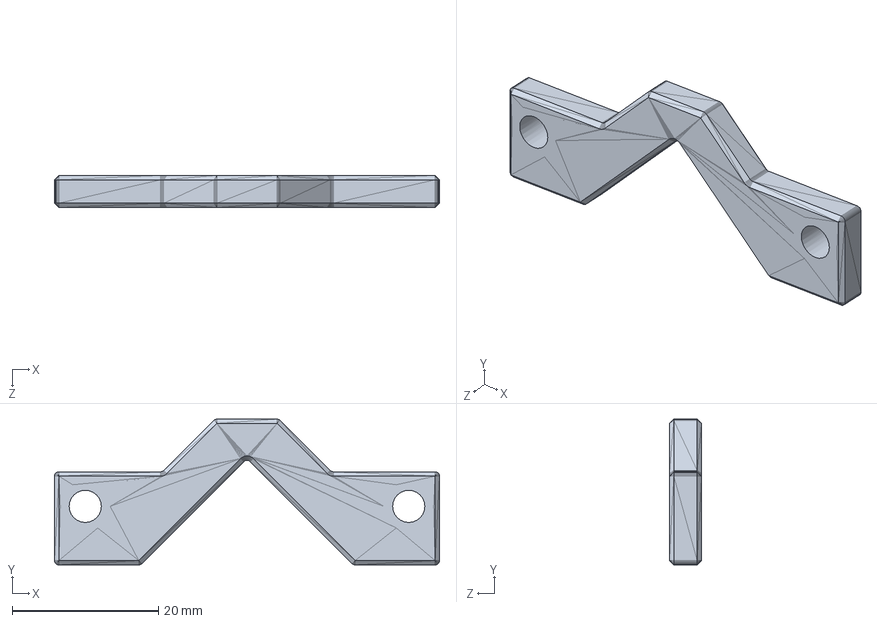
[picture p54: CAD file, 2023-06-23]
Design/Syringe/Open-Source_Syringe_Pump_4194094/files/sideSyringeHolderM4FilledIn.SLDPRT
52.6 x 19.9 x 4.40 mm
