caee/Low-Cost-Bioprinter/Design/Syringe/Open-Source_Syringe_Pump_4194094/files/frontSupport.SLDPRT

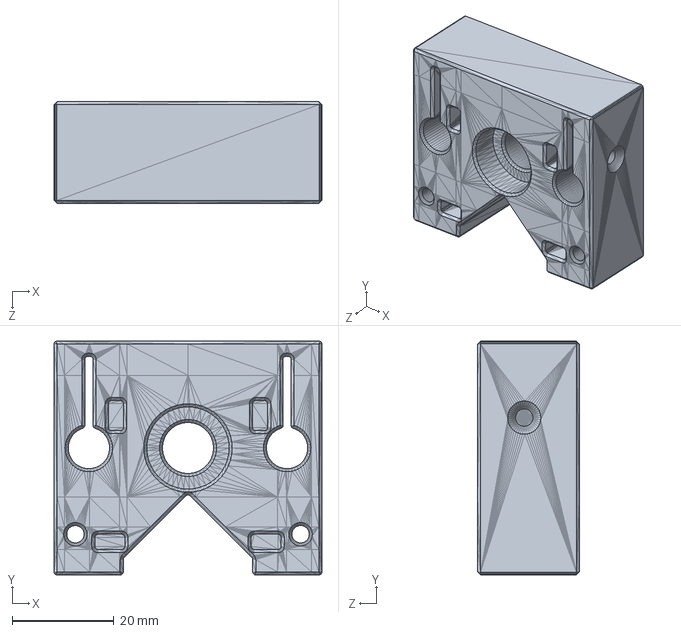
[picture p55: CAD file, 2023-06-23]
Design/Syringe/Open-Source_Syringe_Pump_4194094/files/frontSupport.SLDPRT
52.6 x 45.9 x 20.0 mm
