caee/Low-Cost-Bioprinter/Design/Syringe/Open-Source_Syringe_Pump_4194094/files/ToolHolderRevamped_shorter7mm.STL

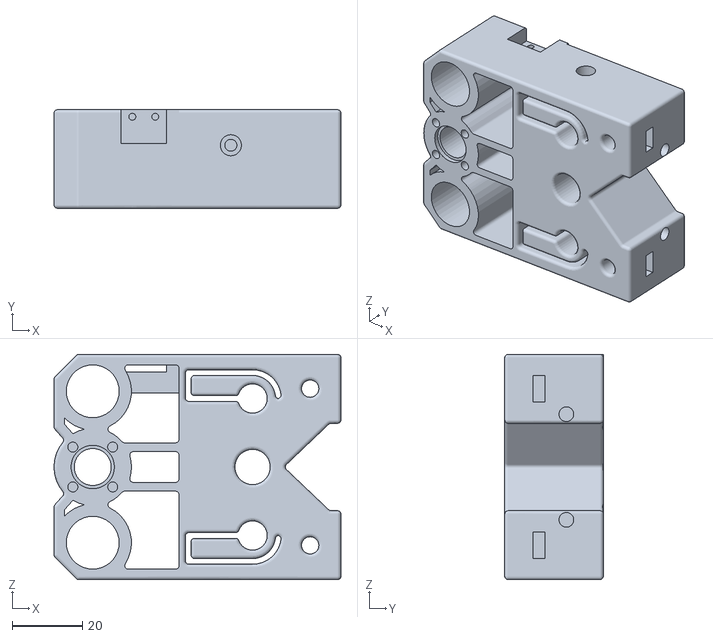
[picture p56: CAD file, 2023-06-23]
Design/Syringe/Open-Source_Syringe_Pump_4194094/files/ToolHolderRevamped_shorter7mm.STL
81.5 x 28.0 x 64.0
