caee/Low-Cost-Bioprinter/Design/Physical printer design/Closed_case_design.SLDPRT

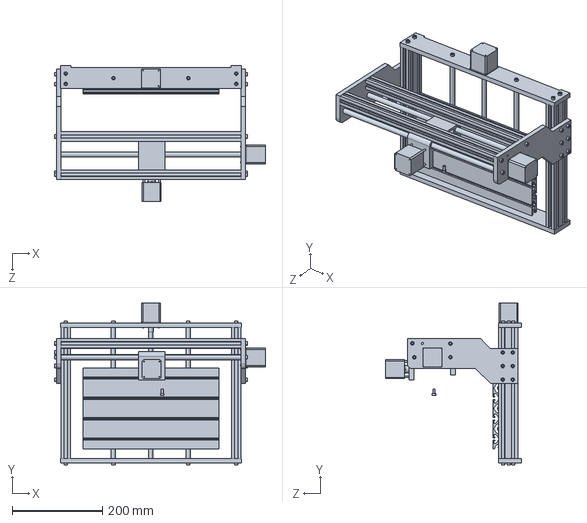
[picture p57: CAD file, 2023-06-23]
Design/Physical printer design/Closed_case_design.SLDPRT
466.4 x 358.0 x 300.3 mm
