caee/Low-Cost-Bioprinter/Design/Syringe/Open-Source_Syringe_Pump_4194094/files/limitStop.SLDPRT

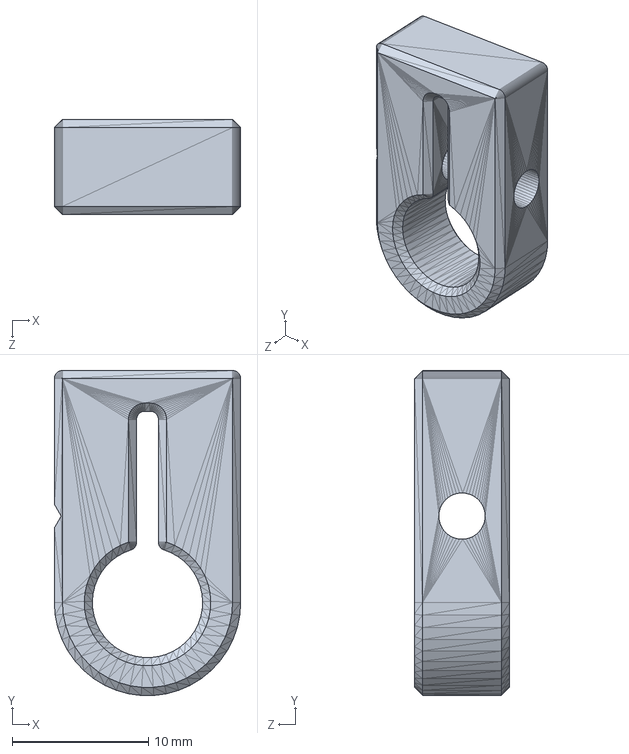
[picture p58: CAD file, 2023-06-23]
Design/Syringe/Open-Source_Syringe_Pump_4194094/files/limitStop.SLDPRT
13.7 x 23.9 x 7.00 mm
