caee/Low-Cost-Bioprinter/Design/Syringe/Open-Source_Syringe_Pump_4194094/files/handKnob7mm.SLDPRT

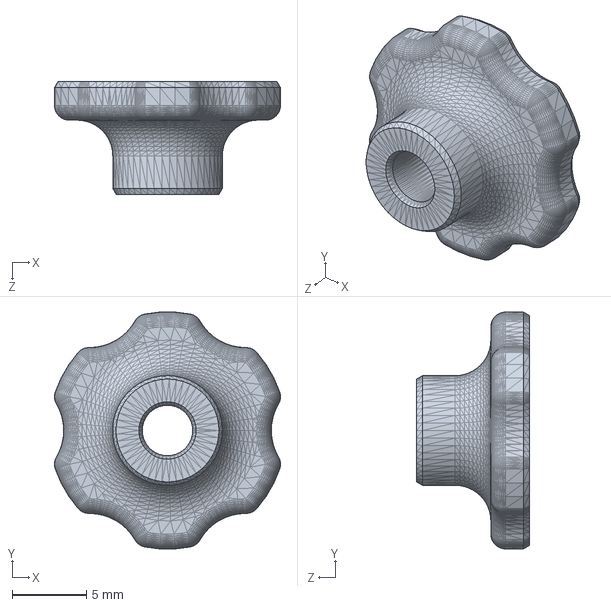
[picture p59: CAD file, 2023-06-23]
Design/Syringe/Open-Source_Syringe_Pump_4194094/files/handKnob7mm.SLDPRT
15.2 x 16.0 x 7.60 mm
