caee/Low-Cost-Bioprinter/Design/Syringe/Open-Source_Syringe_Pump_4194094/files/coupling.SLDPRT

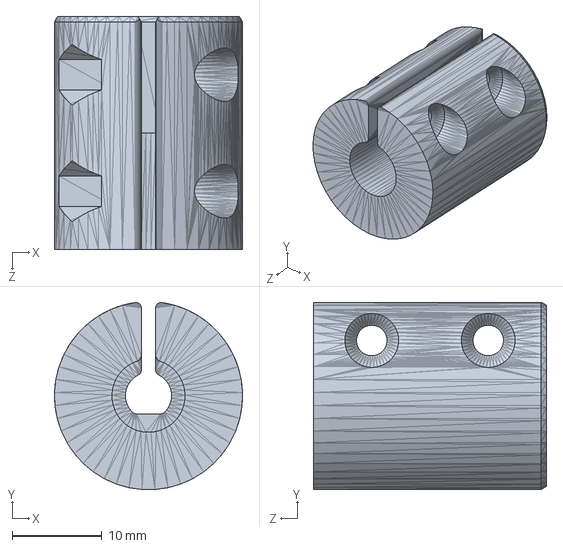
[picture p60: CAD file, 2023-06-23]
Design/Syringe/Open-Source_Syringe_Pump_4194094/files/coupling.SLDPRT
21.0 x 20.9 x 26.0 mm
