caee/Low-Cost-Bioprinter/Design/Syringe/Open-Source_Syringe_Pump_4194094/files/handKnob8mm.SLDPRT

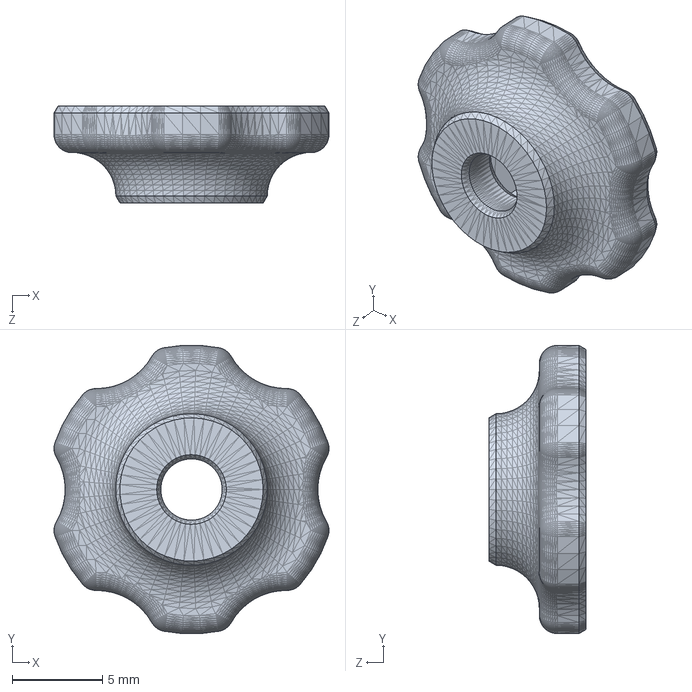
[picture p61: CAD file, 2023-06-23]
Design/Syringe/Open-Source_Syringe_Pump_4194094/files/handKnob8mm.SLDPRT
15.2 x 16.0 x 5.40 mm
