caee/Low-Cost-Bioprinter/Design/Syringe/Open-Source_Syringe_Pump_4194094/files/Tool holder_shorter_5mm.SLDPRT

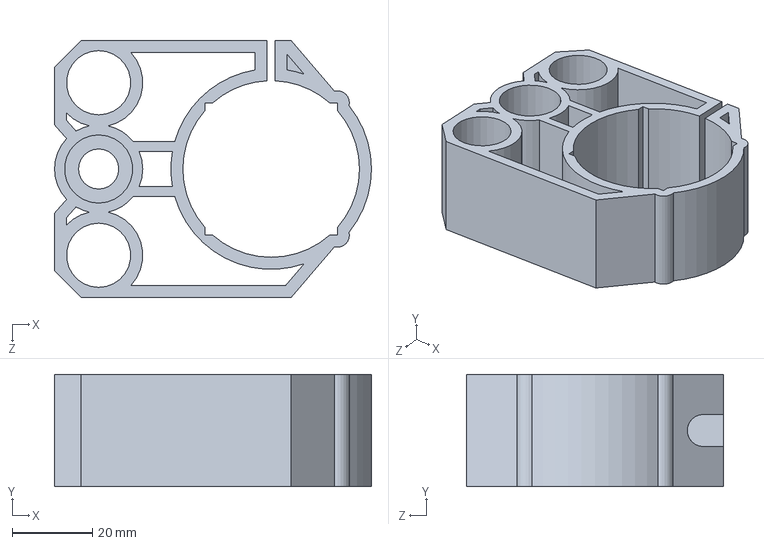
[picture p63: CAD file, 2023-06-23]
Design/Syringe/Open-Source_Syringe_Pump_4194094/files/Tool holder_shorter_5mm.SLDPRT
79.0 x 28.0 x 64.0 mm
