caee/Low-Cost-Bioprinter/Design/Syringe/Open-Source_Syringe_Pump_4194094/files/Tool holder.SLDPRT

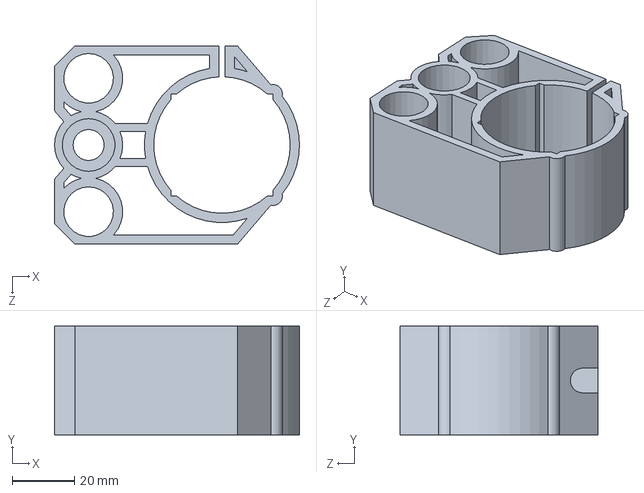
[picture p64: CAD file, 2023-06-23]
Design/Syringe/Open-Source_Syringe_Pump_4194094/files/Tool holder.SLDPRT
79.0 x 35.0 x 64.0 mm
