caee/Low-Cost-Bioprinter/Design/Syringe/Open-Source_Syringe_Pump_4194094/files/ToolHolderRevampedFlexed.STL

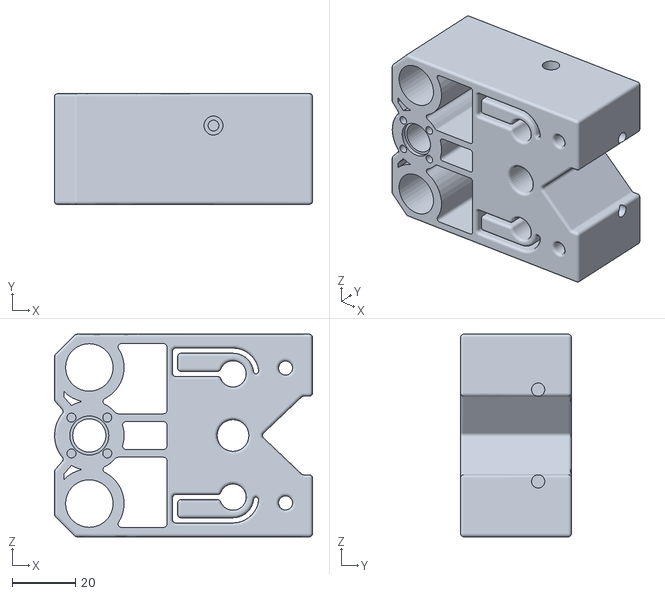
[picture p65: CAD file, 2023-06-23]
Design/Syringe/Open-Source_Syringe_Pump_4194094/files/ToolHolderRevampedFlexed.STL
81.5 x 35.0 x 64.0
