caee/Low-Cost-Bioprinter/Design/Syringe/Open-Source_Syringe_Pump_4194094/files/topSyringeHolder25mm.SLDPRT

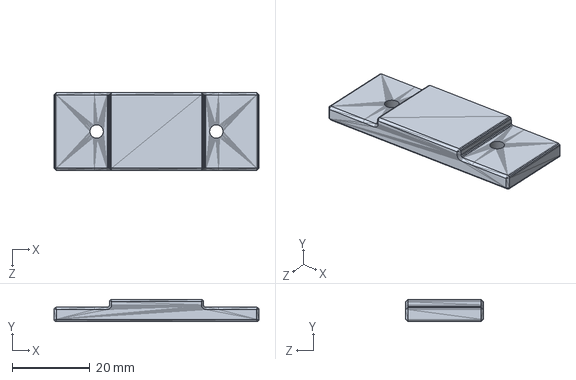
[picture p66: CAD file, 2023-06-23]
Design/Syringe/Open-Source_Syringe_Pump_4194094/files/topSyringeHolder25mm.SLDPRT
52.6 x 5.70 x 20.0 mm
