caee/Low-Cost-Bioprinter/Design/Syringe/Open-Source_Syringe_Pump_4194094/files/backSupport.SLDPRT

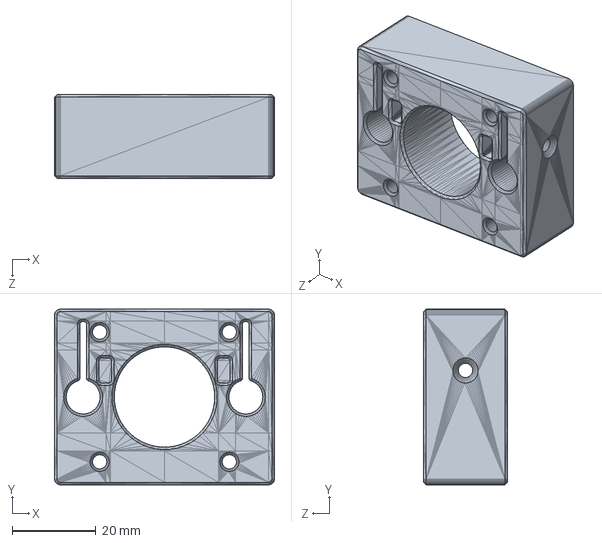
[picture p67: CAD file, 2023-06-23]
Design/Syringe/Open-Source_Syringe_Pump_4194094/files/backSupport.SLDPRT
52.6 x 42.0 x 20.0 mm
