caee/Low-Cost-Bioprinter/Design/Syringe/Open-Source_Syringe_Pump_4194094/files/HandKnob7mm_v2_ny.STL

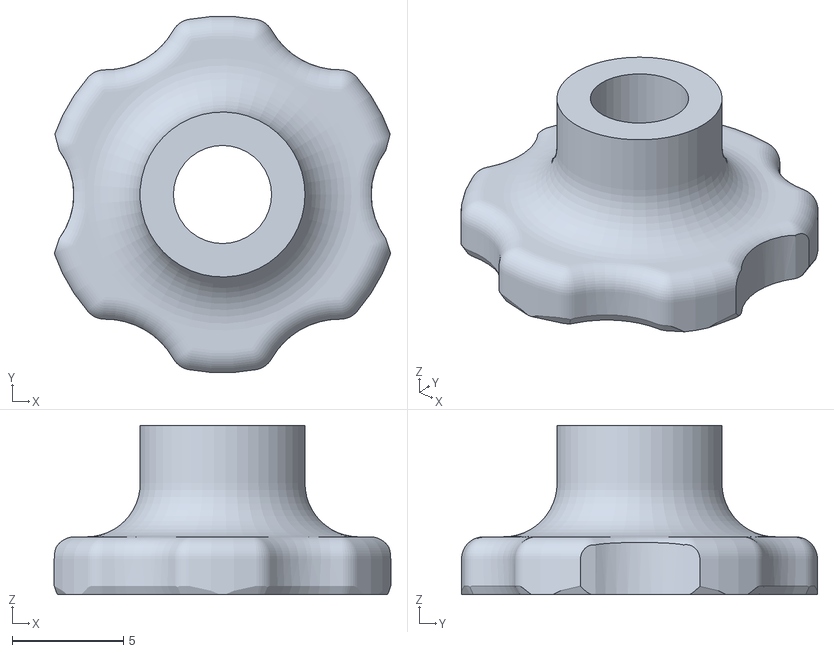
[picture p68: CAD file, 2023-06-23]
Design/Syringe/Open-Source_Syringe_Pump_4194094/files/HandKnob7mm_v2_ny.STL
15.1 x 16.0 x 7.60
