caee/Low-Cost-Bioprinter/Design/Physical printer design/SaintSmart3018_Black.STEP

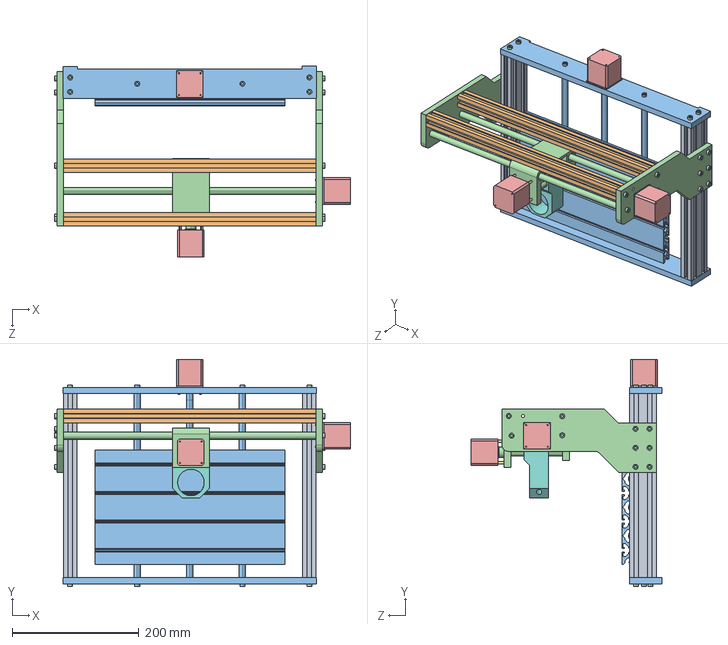
[picture p69: CAD file, 2023-06-23]
Design/Physical printer design/SaintSmart3018_Black.STEP
466.4 x 358.0 x 300.3 mm
