caee/Low-Cost-Bioprinter/(list of files, cad)

Other CAD files:
Design/Physical printer design/SaintSmart3018_Black45.SLDPRT
Design/Syringe/Tool holder.SLDPRT
Software/Printer_settings_cura.3mf
Design/Physical printer design/SaintSmart3018_Black74.SLDPRT
Design/Syringe/Ender3-syringe-pumps-main/Hardware/STEP/Dovetail Cap v1.step
Design/Syringe/Ender3-syringe-pumps-main/Hardware/STL/Large shaft coupler/X X Motor Stepper Mount Large Shaft Coupler v1.stl
Design/Physical printer design/SaintSmart3018_Black75.SLDPRT
Design/Syringe/Ender3-syringe-pumps-main/Hardware/sldprt/E Stepper Mount.SLDPRT
Design/Physical printer design/SaintSmart3018_Black61.SLDPRT
Design/Syringe/Ender3-syringe-pumps-main/Hardware/STL/50 mL adaptors/E End Mount 50 mL.stl
Design/Syringe/Open-Source_Syringe_Pump_4194094/files/sideSyringeHolder.SLDPRT
Design/Physical printer design/SaintSmart3018_Black11.SLDPRT
Design/Syringe/Ender3-syringe-pumps-main/Hardware/STL/50 mL adaptors/X X Motor End Mount 50mL v2.stl
Design/Board.SLDPRT
Design/Physical printer design/SaintSmart3018_Black80.SLDPRT
Design/Syringe/Ender3-syringe-pumps-main/Hardware/sldprt/E Slide Mount.SLDPRT
Design/Physical printer design/SaintSmart3018_Black85.SLDPRT
Design/Syringe/Ender3-syringe-pumps-main/Hardware/STEP/X Motor Slide Mount v1.step
Design/Physical printer design/SaintSmart3018_Black23.SLDPRT
Design/Physical printer design/SaintSmart3018_Black29.SLDPRT
Design/Physical printer design/SaintSmart3018_Black26.SLDPRT
Design/Syringe/Ender3-syringe-pumps-main/Hardware/sldprt/PSU Mount.SLDPRT
Design/Physical printer design/SaintSmart3018_Black70.SLDPRT
Design/Syringe/Ender3-syringe-pumps-main/Hardware/STEP/E End Mount v1.step
Design/Physical printer design/SaintSmart3018_Black50.SLDPRT
Design/Syringe/Ender3-syringe-pumps-main/Hardware/STEP/Electronics Base v1.step
Design/Physical printer design/SaintSmart3018_Black18.SLDPRT
Design/Syringe/Ender3-syringe-pumps-main/Hardware/STEP/E Stepper Mount v1.step
Design/Syringe/Open-Source_Syringe_Pump_4194094/files/SliderM4.SLDPRT
Design/Physical printer design/SaintSmart3018_Black6.SLDPRT
Design/Syringe/Open-Source_Syringe_Pump_4194094/files/ToolHolder2Revamped.STL
Design/Physical printer design/SaintSmart3018_Black93.SLDPRT
Design/Physical printer design/SaintSmart3018_Black78.SLDPRT
Design/Physical printer design/SaintSmart3018_Black69.SLDPRT
Design/Syringe/Open-Source_Syringe_Pump_4194094/files/ToolHolderRevampednynyny.STL
Design/Physical printer design/SaintSmart3018_Black46.SLDPRT
Design/Physical printer design/SaintSmart3018_Black76.SLDPRT
Design/Syringe/Open-Source_Syringe_Pump_4194094/files/frontSupport - imported.SLDPRT
Design/Physical printer design/SaintSmart3018_Black57.SLDPRT
Design/Physical printer design/SaintSmart3018_Black10.SLDPRT
Design/Physical printer design/SaintSmart3018_Black47.SLDPRT
Design/Physical printer design/SaintSmart3018_Black53.SLDPRT
Design/Physical printer design/SaintSmart3018_Black83.SLDPRT
Design/Syringe/Open-Source_Syringe_Pump_4194094/files/ToolHolder3Revamped.STL
Design/Physical printer design/SaintSmart3018_Black54.SLDPRT
Design/Physical printer design/SaintSmart3018_Black38.SLDPRT
Design/Physical printer design/SaintSmart3018_Black21.SLDPRT
Design/Physical printer design/SaintSmart3018_Black41.SLDPRT
Design/Physical printer design/SaintSmart3018_Black14.SLDPRT
Design/Syringe/Open-Source_Syringe_Pump_4194094/files/carriage.stl
Design/Physical printer design/SaintSmart3018_Black56.SLDPRT
Design/Physical printer design/SaintSmart3018_Black1.SLDPRT
Design/Physical printer design/SaintSmart3018_Black33.SLDPRT
Design/Syringe/Open-Source_Syringe_Pump_4194094/files/plungerHolders.SLDPRT
Design/Physical printer design/SaintSmart3018_Black37.SLDPRT
Design/Physical printer design/SaintSmart3018_Black36.SLDPRT
Design/Physical printer design/SaintSmart3018_Black49.SLDPRT
Design/Physical printer design/SaintSmart3018_Black77.SLDPRT
Design/Physical printer design/SaintSmart3018_Black62.SLDPRT
Design/Physical printer design/SaintSmart3018_Black31.SLDPRT
Design/Physical printer design/SaintSmart3018_Black42.SLDPRT
Design/Physical printer design/SaintSmart3018_Black87.SLDPRT
Design/Physical printer design/SaintSmart3018_Black5.SLDPRT
Design/Physical printer design/SaintSmart3018_Black30.SLDPRT
Design/Physical printer design/SaintSmart3018_Black22.SLDPRT
Design/Physical printer design/SaintSmart3018_Black28.SLDPRT
Design/Physical printer design/SaintSmart3018_Black59.SLDPRT
Design/Physical printer design/SaintSmart3018_Black24.SLDPRT
Design/Physical printer design/SaintSmart3018_Black51.SLDPRT
Design/Physical printer design/SaintSmart3018_Black20.SLDPRT
Design/Physical printer design/SaintSmart3018_Black27.SLDPRT
Design/Physical printer design/SaintSmart3018_Black35.SLDPRT
Design/Physical printer design/SaintSmart3018_Black91.SLDPRT
Design/Physical printer design/SaintSmart3018_Black90.SLDPRT
Design/Physical printer design/SaintSmart3018_Black58.SLDPRT
Design/Physical printer design/SaintSmart3018_Black60.SLDPRT
Design/Physical printer design/SaintSmart3018_Black68.SLDPRT
Design/Physical printer design/SaintSmart3018_Black4.SLDPRT
Design/Physical printer design/SaintSmart3018_Black16.SLDPRT
Design/Physical printer design/SaintSmart3018_Black79.SLDPRT
Design/Physical printer design/SaintSmart3018_Black44.SLDPRT
Design/Physical printer design/SaintSmart3018_Black25.SLDPRT
Design/Physical printer design/SaintSmart3018_Black19.SLDPRT
Design/Physical printer design/SaintSmart3018_Black84.SLDPRT
Design/Physical printer design/SaintSmart3018_Black55.SLDPRT
Design/Physical printer design/SaintSmart3018_Black32.SLDPRT
Design/Physical printer design/SaintSmart3018_Black65.SLDPRT
Design/Physical printer design/SaintSmart3018_Black17.SLDPRT
Design/Physical printer design/SaintSmart3018_Black2.SLDPRT
Design/Physical printer design/SaintSmart3018_Black89.SLDPRT
Design/Syringe/Ender3-syringe-pumps-main/Hardware/Ender 3 V2/psu_mount_Ender3v2.scad
Design/Physical printer design/SaintSmart3018_Black.SLDPRT
Design/Physical printer design/SaintSmart3018_Black.dwg
Design/Physical printer design/SaintSmart3018_Black.stl
Design/Physical printer design/SaintSmart3018_Black12.SLDPRT
Design/Physical printer design/SaintSmart3018_Black13.SLDPRT
Design/Physical printer design/SaintSmart3018_Black15.SLDPRT
Design/Physical printer design/SaintSmart3018_Black3.SLDPRT
Design/Physical printer design/SaintSmart3018_Black34.SLDPRT
Design/Physical printer design/SaintSmart3018_Black39.SLDPRT
Design/Physical printer design/SaintSmart3018_Black40.SLDPRT
Design/Physical printer design/SaintSmart3018_Black43.SLDPRT
Design/Physical printer design/SaintSmart3018_Black48.SLDPRT
Design/Physical printer design/SaintSmart3018_Black52.SLDPRT
Design/Physical printer design/SaintSmart3018_Black63.SLDPRT
Design/Physical printer design/SaintSmart3018_Black64.SLDPRT
Design/Physical printer design/SaintSmart3018_Black66.SLDPRT
Design/Physical printer design/SaintSmart3018_Black67.SLDPRT
Design/Physical printer design/SaintSmart3018_Black7.SLDPRT
Design/Physical printer design/SaintSmart3018_Black71.SLDPRT
Design/Physical printer design/SaintSmart3018_Black72.SLDPRT
Design/Physical printer design/SaintSmart3018_Black73.SLDPRT
Design/Physical printer design/SaintSmart3018_Black8.SLDPRT
Design/Physical printer design/SaintSmart3018_Black81.SLDPRT
Design/Physical printer design/SaintSmart3018_Black82.SLDPRT
Design/Physical printer design/SaintSmart3018_Black86.SLDPRT
Design/Physical printer design/SaintSmart3018_Black88.SLDPRT
Design/Physical printer design/SaintSmart3018_Black9.SLDPRT
Design/Physical printer design/SaintSmart3018_Black92.SLDPRT
Design/Syringe/Ender3-syringe-pumps-main/Hardware/F3D/50 mL adaptors/E End Mount 50 mL.f3d
Design/Syringe/Ender3-syringe-pumps-main/Hardware/F3D/50 mL adaptors/E End Mount Dual 50 mL.f3d
Design/Syringe/Ender3-syringe-pumps-main/Hardware/F3D/50 mL adaptors/X X Motor End Mount 50 mL.f3d
Design/Syringe/Ender3-syringe-pumps-main/Hardware/F3D/50 mL adaptors/X X Motor End Mount Dual 50 mL.f3d
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
