caee/Low-Cost-Bioprinter/Design/Syringe/Ender3-syringe-pumps-main/Software/Steps mL Calculation.xlsx

Part Description | Type | Step angle (deg) | Microstep | Pitch (mm)
Stepper Motor | BJ42D15-26V09 | 1.8
Stepper Driver | TMC2208 |  | 16
Leadscrew | M5x0.8 |  |  | 0.8
 |  |  |  | Steps/mm | 4000
 |  |  |  | Min. Movement (mm) | 0.00025
Fill in the inner diameter (ID) of syringe
Syringe | ID (mm) | Area (mm^2) | V/mm (mL) | V/step (mL) | Steps/mL (n)
1 mL | 4.7 | 17.34944543 | 0.01734944543 | 4.337361357e-06 | 230554.9198
5 mL | 12.3 | 118.8228881 | 0.1188228881 | 2.970572204e-05 | 33663.54801
10 mL | 15.6 | 191.134497 | 0.191134497 | 4.778362426e-05 | 20927.67168
20 mL | 20.1 | 317.308712 | 0.317308712 | 7.9327178e-05 | 12606.0201
