caee/Low-Cost-Bioprinter/Figures/Full_Printer.png

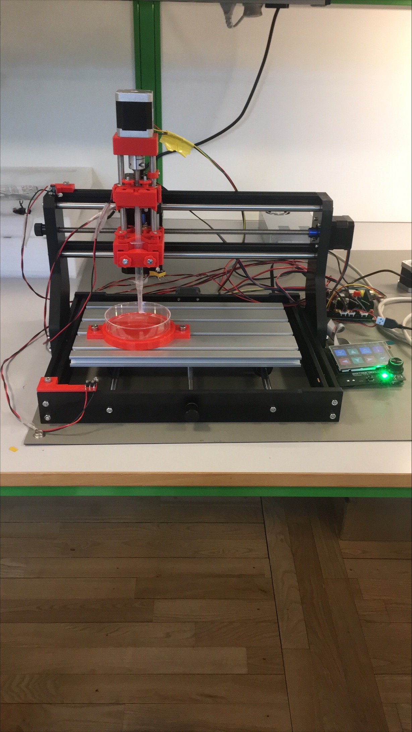
Figures/Full_Printer.png
