caee/Low-Cost-Bioprinter/Figures/Syringe_assembled.png

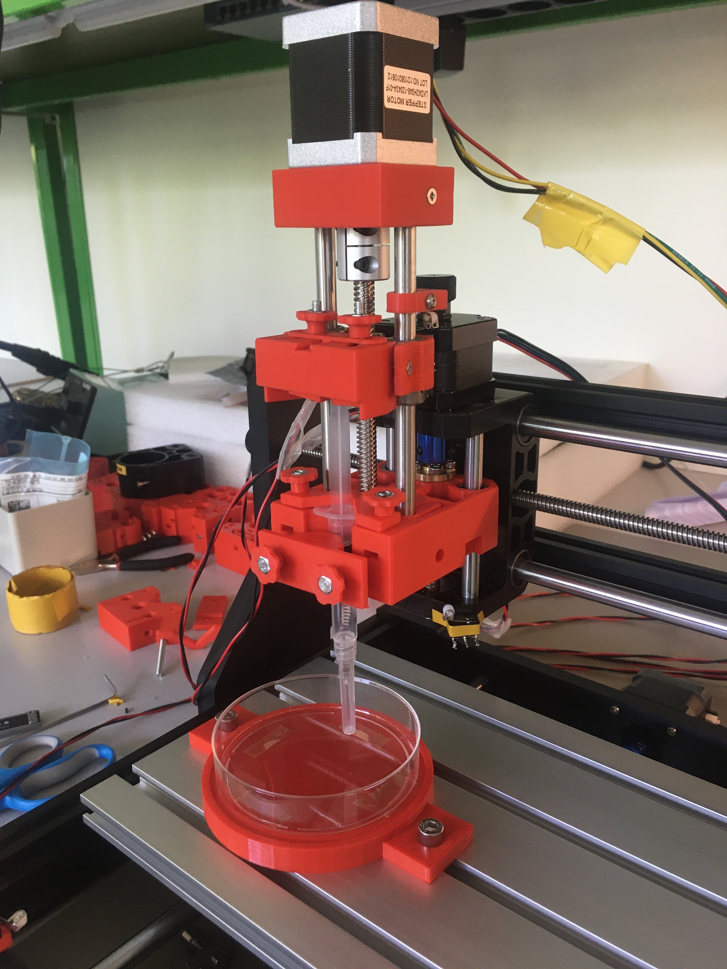
Figures/Syringe_assembled.png
